FredrikLLarsen/STM32F411_DRV8302_FOC_PCBA/STM32 - BLDC Driver/Production/bom.csv

Designator | Footprint | Quantity | Value | LCSC Part #
C1, C11, C12, C42, C43 | 0805 | 5 | 4.7u low esr (C1779)
C10 | 0603 | 1 | 120p (C107035)
C13, C14, C15, C16, C18, C19, C21, C22, C23, C45, C66 | 0805 | 11 | 100nF 50V (C28233)
C17 | 0805 | 1 | 2.2u (C5448893)
C2, C7 | 1206 | 2 | 1uF (C13832)
C20 | 0805 | 1 | 10uF (C15850)
C24, C35 | C_Elec_10x10.2 | 2 | 220uF (C46550422)
C25, C26, C28, C29, C30, C31, C33, C34, C51, C61, C62, C68, C74 | 0805 | 13 | 0.1uF (C28233)
C27 | CP_Elec_5x5.4 | 1 | 47uF_P (C18221497)
C3 | 1206 | 1 | 2.2uF (C920964)
C32 | 0805 | 1 | 0.01uF (C1710)
C36, C37, C38, C39, C40, C75 | 0805 | 6 | 22uF (C45783)
C4 | 0805 | 1 | 10nF (C1710)
C41 | C_Elec_8x10.2 | 1 | 100uF 63V (C7471891)
C44, C67 | 1206 | 2 | 4.7uF 50V (C29823)
C46 | 0805 | 1 | 4.7nF (C1744)
C5, C6 | 0805 | 2 | 2.2nF (C28260)
C53, C56 | 1206 | 2 | 1nF (C9196)
C55, C59, C60 | 1206 | 3 | 2.2uF (C50254)
C8 | 0603 | 1 | 22nF (C376821)
C9 | 0603 | 1 | 6.8n (C1631)
D1 | D_SOD-123 | 1 | D_Zener (C173406)
D2 | D_SMA-SMB_Universal_Handsoldering | 1 | B330A-13-F (C110485)
D5, D7, D8 | D_SOD-323 | 3 | D_Zener (C67528)
J1 | HRS_FH34SRJ-10S-0.5SH_50_ | 1 | FH34SRJ-10S-0.5SH_50_
J10 | TerminalBlock_bornier-3_P5.08mm | 1 | Screw_Terminal_01x03
J2, J4, J5, J7 | PinHeader_1x03_P2.54mm_Vertical | 4 | Conn_01x03_Pin
J3 | PinHeader_1x04_P2.54mm_Vertical | 1 | Conn_01x04_Pin
J8 | G-SWITCH_GT-USB-7010B | 1 | GT-USB-7010B
J9 | AMASS_XT30PW-M_1x02_P2.50mm_Horizontal | 1 | Conn_01x02_Pin
L1 | L_Changjiang_FXL0630 | 1 | 22uH (C177244)
L2, L4 | L_7.3x7.3_H3.5 | 2 | 15uH (C216196)
Q1, Q2, Q3, Q4, Q5, Q6 | TRANS_SIR182DP-T1-RE3 | 6 | SIR182DP-T1-RE3
R1, R11, R12, R13, R2, R5 | 0805 | 6 | 10k (C17414)
R10 | 0603 | 1 | 3.3R (C22979)
R14, R15 | 0603 | 2 | 5.1k (C22356620)
R16, R17 | 0603 | 2 | 0R
R18 | 0603 | 1 | 3k3 (C22356670)
R19 | 0603 | 1 | 18k (C2907111)
R20 | 0603 | 1 | 15k (C22356635)
R21, R23 | 0603 | 2 | 2.2k (C4190)
R26, R27 | 0603 | 2 | 56R (C2930118)
R28 | 0603 | 1 | 1k (C22356624)
R29 | 0805 | 1 | 80.6k (C2960781)
R31 | 0805 | 1 | 8.2k (C17828)
R4 | 0805 | 1 | 0R (C17477)
R42, R55 | 2512 | 2 | 10mOhm (C393072)
R43, R50, R52, R9 | 0603 | 4 | 34.8k (C23141)
R44, R46, R49, R51, R53, R56 | 0805 | 6 | 10R (C17415)
R45, R47, R48, R6 | 0603 | 4 | 4.99k (C23046)
R59, R62 | 0805 | 2 | 64.9k (C17788)
R60 | 0603 | 1 | 100k (C15458)
R61, R64 | 0805 | 2 | 24.9k (C17571)
R63 | 0603 | 1 | 57.6k (C204216)
R7 | 0603 | 1 | 200k (C25811)
R8 | 0402 | 1 | 1M (C26083)
TH1 | 0805 | 1 | CMFB103F3950FANT (C51597)
TP10, TP15, TP16, TP19, TP20, TP21, TP23, TP24, TP25, TP26 | TestPoint_Pad_D3.0mm | 10 | TestPoint
TP11, TP12, TP6 | TestPoint_Pad_D4.0mm | 3 | TestPoint
U1, U3 | DDA0008E-IPC_A | 2 | LMR38020SDDAR
U2 | SOP50P810X120-57N | 1 | DRV8302DCAR
U4 | SOT-223-3_TabPin2 | 1 | LD1117S33TR_SOT223
U5 | QFN-48-1EP_7x7mm_P0.5mm_EP5.6x5.6mm | 1 | STM32F411CEUx
U6, U7 | SOT-363_SC-70-6 | 2 | LM66100DCK
Y1 | Crystal_SMD_3225-4Pin_3.2x2.5mm_HandSoldering | 1 | Crystal_GND24 (C5444547)
