FredrikLLarsen/STM32F411_DRV8302_FOC_PCBA/STM32 - BLDC Driver/FL50-15 Adapter/production/bom.csv

Designator | Footprint | Quantity | Value | LCSC Part #
J1 | PinHeader_1x10_P2.54mm_Vertical | 1 | Conn_01x10_Pin
J7 | HRS_FH34SRJ-10S-0.5SH_50_ | 1 | FH34SRJ-10S-0.5SH_50_
