FredrikLLarsen/STM32F411_DRV8302_FOC_PCBA/STM32 - BLDC Driver/Production/REV_B/STM32 - BLDC Driver - REVB BOM.csv

Reference | Qty | Value | DNP | Exclude from BOM | Exclude from Board | Footprint | Datasheet
C1,C11,C12,C50 | 4 | 4.7u low esr (C1779) |  |  |  | Capacitor_SMD:C_0805_2012Metric_Pad1.18x1.45mm_HandSolder | ~
C2,C7 | 2 | 1uF (C13832) |  |  |  | Capacitor_SMD:C_1206_3216Metric_Pad1.33x1.80mm_HandSolder | ~
C3 | 1 | 2.2uF (C920964) |  |  |  | Capacitor_SMD:C_1206_3216Metric_Pad1.33x1.80mm_HandSolder | ~
C4 | 1 | 10nF (C1710) |  |  |  | Capacitor_SMD:C_0805_2012Metric_Pad1.18x1.45mm_HandSolder | ~
C5,C6 | 2 | 2.2nF (C28260) |  |  |  | Capacitor_SMD:C_0805_2012Metric_Pad1.18x1.45mm_HandSolder | ~
C8 | 1 | 22nF (C376821) |  |  |  | Capacitor_SMD:C_0603_1608Metric_Pad1.08x0.95mm_HandSolder | ~
C9 | 1 | 6.8n (C1631) |  |  |  | Capacitor_SMD:C_0603_1608Metric_Pad1.08x0.95mm_HandSolder | ~
C10 | 1 | 120p (C107035) |  |  |  | Capacitor_SMD:C_0603_1608Metric_Pad1.08x0.95mm_HandSolder | ~
C20 | 1 | 10uF (C15850) |  |  |  | Capacitor_SMD:C_0805_2012Metric_Pad1.18x1.45mm_HandSolder | ~
C23,C37,C44,C45,C47,C48,C49,C52,C54 | 9 | 100nF 50V (C28233) |  |  |  | Capacitor_SMD:C_0805_2012Metric_Pad1.18x1.45mm_HandSolder | ~
C24,C35 | 2 | 220uF (C46550422) |  |  |  | Capacitor_SMD:C_Elec_10x10.2 | ~
C25,C26,C28,C29,C30,C31,C33,C34,C40,C42,C51,C62 | 12 | 0.1uF (C28233) |  |  |  | Capacitor_SMD:C_0805_2012Metric_Pad1.18x1.45mm_HandSolder | ~
C27 | 1 | 47uF_P (C18221497) |  |  |  | Capacitor_SMD:CP_Elec_5x5.4 | ~
C32 | 1 | 0.01uF (C1710) |  |  |  | Capacitor_SMD:C_0805_2012Metric_Pad1.18x1.45mm_HandSolder | ~
C36 | 1 | C22036 |  |  |  | Capacitor_Tantalum_SMD:CP_EIA-3528-21_Kemet-B | ~
C38,C53 | 2 | 1nF (C9196) |  |  |  | Capacitor_SMD:C_1206_3216Metric | ~
C39,C55,C60 | 3 | 2.2uF (C50254) |  |  |  | Capacitor_SMD:C_1206_3216Metric_Pad1.33x1.80mm_HandSolder | ~
C41 | 1 | 100uF 63V (C7471891) |  |  |  | Capacitor_SMD:C_Elec_8x10.2 | ~
C43 | 1 | 2.2u C5448893 |  |  |  | Capacitor_SMD:C_0805_2012Metric_Pad1.18x1.45mm_HandSolder | ~
C46 | 1 | 4.7nF (C1744) |  |  |  | Capacitor_SMD:C_0805_2012Metric_Pad1.18x1.45mm_HandSolder | ~
C56 | 1 | 1nF (C9196) |  |  |  | Capacitor_SMD:C_1206_3216Metric_Pad1.33x1.80mm_HandSolder | ~
C57,C58 | 2 | 10pF (C520053) |  |  |  | Capacitor_SMD:C_0805_2012Metric_Pad1.18x1.45mm_HandSolder | ~
D1 | 1 | D_Zener (C173406) |  |  |  | Diode_SMD:D_SOD-123 | ~
D2 | 1 | B330A-13-F (C110485) |  |  |  | Diode_SMD:D_SMA-SMB_Universal_Handsoldering | ~
D3,D9,D15 | 3 | C84260 |  |  |  | LED_SMD:LED_0805_2012Metric_Pad1.15x1.40mm_HandSolder | ~
D4,D6,D7,D11 | 4 | C5342734 |  |  |  | LED_SMD:LED_0603_1608Metric_Pad1.05x0.95mm_HandSolder | ~
D5,D8,D14 | 3 | D_Zener (C67528) |  |  |  | Diode_SMD:D_SOD-323 | ~
D10 | 1 | IN5819 (C437199) |  |  |  | Diode_SMD:D_SMA_Handsoldering | ~
D12,D13 | 2 | C511254 |  |  |  | Diode_SMD:D_SOD-323_HandSoldering | ~
H1,H2,H3,H4 | 4 | MountingHole_Pad |  | Excluded from BOM |  | MountingHole:MountingHole_3.2mm_M3_Pad_Via | ~
J1 | 1 | FH34SRJ-10S-0.5SH_50_ |  |  |  | FH34SRJ-10S-0.5SH:HRS_FH34SRJ-10S-0.5SH_50_
J2,J4,J5,J12 | 4 | Conn_01x03_Pin |  |  |  | Connector_PinHeader_2.54mm:PinHeader_1x03_P2.54mm_Vertical | ~
J3,J11 | 2 | Conn_01x04_Socket |  |  |  | Connector_JST:JST_XH_B4B-XH-A_1x04_P2.50mm_Vertical | ~
J6 | 1 | TC2050 |  | Excluded from BOM |  | Connector:Tag-Connect_TC2050-IDC-NL_2x05_P1.27mm_Vertical | https://www.tag-connect.com/wp-content/uploads/bsk-pdf-manager/TC2050-IDC-NL_Datasheet_8.pdf
J7 | 1 | Conn_01x06_Pin |  |  |  | Connector_PinSocket_2.00mm:PinSocket_1x06_P2.00mm_Vertical | ~
J8 | 1 | GT-USB-7010B |  |  |  | GT-USB-7010B:G-SWITCH_GT-USB-7010B
J9 | 1 | Conn_01x02_Pin |  |  |  | Connector_AMASS:AMASS_XT30PW-M_1x02_P2.50mm_Horizontal | ~
J10 | 1 | Screw_Terminal_01x03 |  |  |  | TerminalBlock:TerminalBlock_bornier-3_P5.08mm | ~
J13 | 1 | Conn_01x02 |  |  |  | Connector_JST:JST_XH_B2B-XH-A_1x02_P2.50mm_Vertical | ~
JP1,JP2,JP3,JP4,JP5,JP6,JP7,JP8,JP9,JP10,JP11,JP12,JP13,JP14,JP15,JP16,JP17,JP18,JP20 | 19 | SolderJumper_2_Open |  | Excluded from BOM |  | Jumper:SolderJumper-2_P1.3mm_Open_RoundedPad1.0x1.5mm | ~
JP19 | 1 | SolderJumper_2_Open |  | Excluded from BOM |  |  | ~
L1 | 1 | 22uH (C177244) |  |  |  | Inductor_SMD:L_Changjiang_FXL0630 | ~
L2 | 1 | C5189962 |  |  |  | Inductor_SMD:L_Bourns_SRP7028A_7.3x6.6mm | ~
NT1 | 1 | NetTie_3_Tee |  | Excluded from BOM |  | NetTie:NetTie-3_SMD_Pad0.5mm | ~
NT3,NT4,NT6,NT7,NT8,NT9 | 6 | NetTie_2 |  | Excluded from BOM |  | NetTie:NetTie-2_SMD_Pad0.5mm | ~
Q1,Q2,Q4,Q6,Q7,Q8 | 6 | C431185 |  |  |  | SIR182DP:TRANS_SIR182DP-T1-RE3
R1,R2,R5,R11,R12,R30 | 6 | 10k (C17414) |  |  |  | Resistor_SMD:R_0805_2012Metric_Pad1.20x1.40mm_HandSolder | ~
R3,R25,R40 | 3 | 0R (C95177) |  |  |  | Resistor_SMD:R_0603_1608Metric_Pad0.98x0.95mm_HandSolder | ~
R4 | 1 | 100R (C105588) |  |  |  | Resistor_SMD:R_0603_1608Metric_Pad0.98x0.95mm_HandSolder | ~
R6,R38,R45,R48 | 4 | 4.99k (C23046) |  |  |  | Resistor_SMD:R_0603_1608Metric_Pad0.98x0.95mm_HandSolder | ~
R7 | 1 | 200k (C25811) |  |  |  | Resistor_SMD:R_0603_1608Metric_Pad0.98x0.95mm_HandSolder | ~
R8 | 1 | 1M (C26083) |  |  |  | Resistor_SMD:R_0402_1005Metric_Pad0.72x0.64mm_HandSolder | ~
R9,R37,R43,R52 | 4 | 34.8k (C23141) |  |  |  | Resistor_SMD:R_0603_1608Metric_Pad0.98x0.95mm_HandSolder | ~
R10 | 1 | 3.3R (C22979) |  |  |  | Resistor_SMD:R_0603_1608Metric_Pad0.98x0.95mm_HandSolder | ~
R13,R22,R24,R33 | 4 | 820R (C137608) |  |  |  | Resistor_SMD:R_0603_1608Metric_Pad0.98x0.95mm_HandSolder | ~
R14,R15,R47 | 3 | 5.1k (C22356620) |  |  |  | Resistor_SMD:R_0603_1608Metric_Pad0.98x0.95mm_HandSolder | ~
R16,R17 | 2 | 0R |  |  |  | Resistor_SMD:R_0603_1608Metric_Pad0.98x0.95mm_HandSolder | ~
R18 | 1 | 10k |  |  |  | Resistor_SMD:R_0603_1608Metric_Pad0.98x0.95mm_HandSolder | ~
R19 | 1 | 31.6k |  |  |  | Resistor_SMD:R_0603_1608Metric_Pad0.98x0.95mm_HandSolder | ~
R20 | 1 | 15k (C22356635) |  |  |  | Resistor_SMD:R_0603_1608Metric_Pad0.98x0.95mm_HandSolder | ~
R21,R23 | 2 | 2.2k (C4190) |  |  |  | Resistor_SMD:R_0603_1608Metric_Pad0.98x0.95mm_HandSolder | ~
R26,R27 | 2 | 56R (C2930118) |  |  |  | Resistor_SMD:R_0603_1608Metric_Pad0.98x0.95mm_HandSolder | ~
R28,R32,R39 | 3 | 1k (C22356624) |  |  |  | Resistor_SMD:R_0603_1608Metric_Pad0.98x0.95mm_HandSolder | ~
R29 | 1 | CHECK VAL |  |  |  | Resistor_SMD:R_0805_2012Metric_Pad1.20x1.40mm_HandSolder | ~
R31 | 1 | 8.2k (C17828) |  |  |  | Resistor_SMD:R_0805_2012Metric_Pad1.20x1.40mm_HandSolder | ~
R34,R35,R44,R46,R49,R51 | 6 | 10R (C17415) |  |  |  | Resistor_SMD:R_0805_2012Metric_Pad1.20x1.40mm_HandSolder | ~
R36,R42,R55 | 3 | 10mOhm (C393072) |  |  |  | Resistor_SMD:R_2512_6332Metric_Pad1.40x3.35mm_HandSolder | ~
R41 | 1 | 0R (C17477) |  |  |  | Resistor_SMD:R_0805_2012Metric_Pad1.20x1.40mm_HandSolder | ~
TH1 | 1 | CMFB103F3950FANT (C51597) |  |  |  | Resistor_SMD:R_0805_2012Metric_Pad1.20x1.40mm_HandSolder | ~
TP7,TP10,TP14,TP23 | 4 | TestPoint |  |  |  | TestPoint:TestPoint_Pad_D1.0mm | ~
U1 | 1 | ME2108A30PG |  |  |  | Package_TO_SOT_SMD:SOT-89-3 | https://www.lcsc.com/datasheet/C19056.pdf
U2 | 1 | DRV8302DCAR |  |  |  | DRV8302DCAR:SOP50P810X120-57N
U3,U6 | 2 | LM66100DCK |  |  |  | Package_TO_SOT_SMD:SOT-363_SC-70-6 | https://www.ti.com/lit/ds/symlink/lm66100.pdf
U4 | 1 | LD1117S33TR_SOT223 |  |  |  | Package_TO_SOT_SMD:SOT-223-3_TabPin2 | http://www.st.com/st-web-ui/static/active/en/resource/technical/document/datasheet/CD00000544.pdf
U7 | 1 | MCP4017T-503E/LT |  |  |  | Package_TO_SOT_SMD:SOT-363_SC-70-6 | http://ww1.microchip.com/downloads/en/DeviceDoc/22147a.pdf
U8 | 1 | STM32F411RCTx |  |  |  | Package_QFP:LQFP-64_10x10mm_P0.5mm | https://www.st.com/resource/en/datasheet/stm32f411rc.pdf
Y2 | 1 | Crystal_GND24 (C5444547) |  |  |  | Crystal:Crystal_SMD_3225-4Pin_3.2x2.5mm_HandSoldering | ~
