FredrikLLarsen/STM32F411_DRV8302_FOC_PCBA/STM 32 - BLDC Driver V3 - VARIANT B/STM32 BLDC Driver V3/_restore_backup_2026-09-18T21-46-55-770/production/HOMEBREW_V3__bom.csv

Designator | Footprint | Quantity | Value | LCSC Part #
C10, C12, C13, C14, C15, C25, C26, C28, C32, C37 | 0603 | 10 | 2.2uF (C57895)
C11, C2, C5, C6, C7, C9 | 0603 | 6 | 22pF (C7419421)
C19, C22, C31, C38 | 1206 | 4 | 1uf 100V (C13832)
C27 | 0603 | 1 | 22nF (C696861)
C29 | 1206 | 1 | 4.7uF 100V (C22367839)
C30 | 0603 | 1 | 220nF 100V (C7300906)
C33, C34 | 0603 | 2 | 22uF 10V (C86295)
C35, C36, C41 | 0603 | 3 | 10uF 10V (C5137565)
C39 | 0805 | 1 | 47uF 10V (C124129)
C43, C47, C48, C49, C50 | 0603 | 5 | 0.1uF (C52711259)
C44, C45 | C_Elec_8x10.2 | 2 | 100uF 63V (C7471891)
C57, C58 | 0805 | 2 | 10pF (C520053)
C62, C63, C80, C82, C83, C84, C85, C86 | 0603 | 8 | 100nF 50V (C1591)
C64, C65, C72 | 0805 | 3 | 100nF 50V (C28233)
C66, C67, C68, C69, C70, C71 | 0805 | 6 | 100nF 100V X7R
C73 | 0603 | 1 | 4.7uF 16V (C7432772)
C74, C75, C76, C77, C78, C79, C81 | 0603 | 7 | 1nF (C374073)
D10, D12, D13, D7, D8, D9 | 0603 | 6 | C5342734
D11 | D_SMA_Handsoldering | 1 | B340A
D14, D15, D16, D17, D18, D19 | D_SMB | 6 | C28646299
IC1 | SOIC127P600X170-9N | 1 | MP1584EN-LF-Z
IC2 | SOT8 | 1 | LM66200DRLR
J1 | PinHeader_1x02_P2.54mm_Vertical | 1 | Conn_01x02_Pin
J11, J5, J7, J8 | STICHED SOLDER PAD_SMALL | 4 | Conn_01x01_Pin
J12 | USB_C_Receptacle_G-Switch_GT-USB-7010ASV | 1 | G-Switch GT-USB-7010ASV
J2, J3, J4 | STICHED SOLDER PAD | 3 | Conn_01x01_Pin
J9 | Molex_Nano-Fit_105313-xx02_1x02_P2.50mm_Horizontal | 1 | Conn_01x02_Pin
JP1, JP10, JP11, JP12, JP13, JP2, JP3, JP5, JP6, JP7, JP8, JP9 | SolderJumper-2_P1.3mm_Open_RoundedPad1.0x1.5mm | 12 | Jumper_2_Small_Open
L1 | L_Abracon_ASPIAIG-F4020 | 1 | 10 µH (C54620135)
L2 | L_Sunlord_MWSA0402S | 1 | 22uH (C41438718)
Q1 | SOT-23 | 1 | BC847
R13, R14, R16, R17, R18, R19 | 0603 | 6 | 10R 0.1W (C109318)
R2, R4, R5, R6, R7, R8 | 0603 | 6 | 2.2R (C2907006)
R20 | 0603 | 1 | 4.3k 1% (C54920924)
R21, R23, R40, R41, R42, R44, R51, R57, R58 | 0603 | 9 | 4k7 100mW (C2907034)
R22, R24, R25, R28, R30, R39, R45 | 0603 | 7 | 820R (C137608)
R26, R29, R32, R34, R43 | 0603 | 5 | 100k 1% (C2906980)
R27 | 0603 | 1 | 24.9k 1% (C2930080)
R33 | 0603 | 1 | 68k (C2907063)
R35 | 0805 | 1 | 250k (C2501409)
R36 | 0603 | 1 | 22k (C2907015)
R37, R38 | 0805 | 2 | 8.2k (C17828)
R46, R47 | 0603 | 2 | 22R (C23345)
R48, R59, R60, R62, R68 | 0603 | 5 | 0R (C2906974)
R52, R53 | 0603 | 2 | 5.1k (C2907044)
R55, R63, R64, R65, R66, R67 | 0603 | 6 | 10k 100mW (C98220)
TH2, TH3 | 0805 | 2 | CMFB103F3950FANT (C51597)
U1, U2, U3 | EPC_QFN-13-3EP_3.5x5mm_P0.5mm | 3 | EPC23104
U10 | LQFP-64_10x10mm_P0.5mm | 1 | STM32G431RBTx
U11 | TSSOP-14_4.4x5mm_P0.65mm | 1 | AS5047D
U13 | SOT-23-6 | 1 | USBLC6-2SC6
U4 | SOIC-16_3.9x9.9mm_P1.27mm | 1 | CH340C
U5 | SOIC-8_3.9x4.9mm_P1.27mm | 1 | 24LC256
U6 | Texas_HTSOP-8-1EP_3.9x4.9mm_P1.27mm_EP2.95x4.9mm_Mask2.4x3.1mm_ThermalVias | 1 | LMR36520ADDA
U7, U8, U9 | SOIC-8_3.9x4.9mm_P1.27mm | 3 | ACS725xLCTR-20AB
Y2 | Crystal_SMD_3225-4Pin_3.2x2.5mm_HandSoldering | 1 | Crystal_GND24 (C5444547)
