FredrikLLarsen/STM32F411_DRV8302_FOC_PCBA/STM 32 - BLDC Driver V3 - VARIANT B/STM32 BLDC Driver V3/_restore_backup_2026-09-18T21-46-55-770/.step

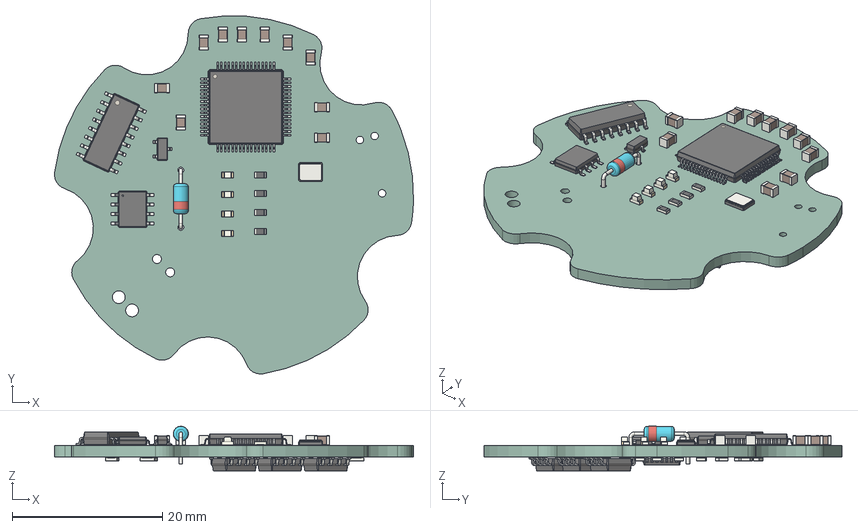
[picture p1: CAD file, 2026-10-09]
STM 32 - BLDC Driver V3 - VARIANT B/STM32 BLDC Driver V3/_restore_backup_2026-09-18T21-46-55-770/.step
47.8 x 47.7 x 5.94 mm
LED_0603_1608Metric x 4
R_0603_1608Metric x 8
LQFP-64_10x10mm_P0.5mm
C_0805_2012Metric x 10
D_DO-35_SOD27_P7.62mm_Horizontal
Texas_HTSOP_8_1EP_39x49mm_P127mm_EP285x49mm_Mask24x31mm_ThermalVias
SOIC-16_3.9x9.9mm_P1.27mm
Crystal_SMD_3225-4Pin_3.2x2.5mm
SOT-23
TSSOP-14_4.4x5mm_P0.65mm
R_0805_2012Metric x 7
SOIC-8_3.9x4.9mm_P1.27mm x 3
STMEC79_PCB
