FredrikLLarsen/STM32F411_DRV8302_FOC_PCBA/STM32 - BLDC Driver V2/AS5047P Encoder/AS5047P Encoder/AS5047P Encoder.kicad_pcb

## KiCad design STM32 - BLDC Driver V2/AS5047P Encoder/AS5047P Encoder/AS5047P Encoder.kicad_pcb (2026-10-09)

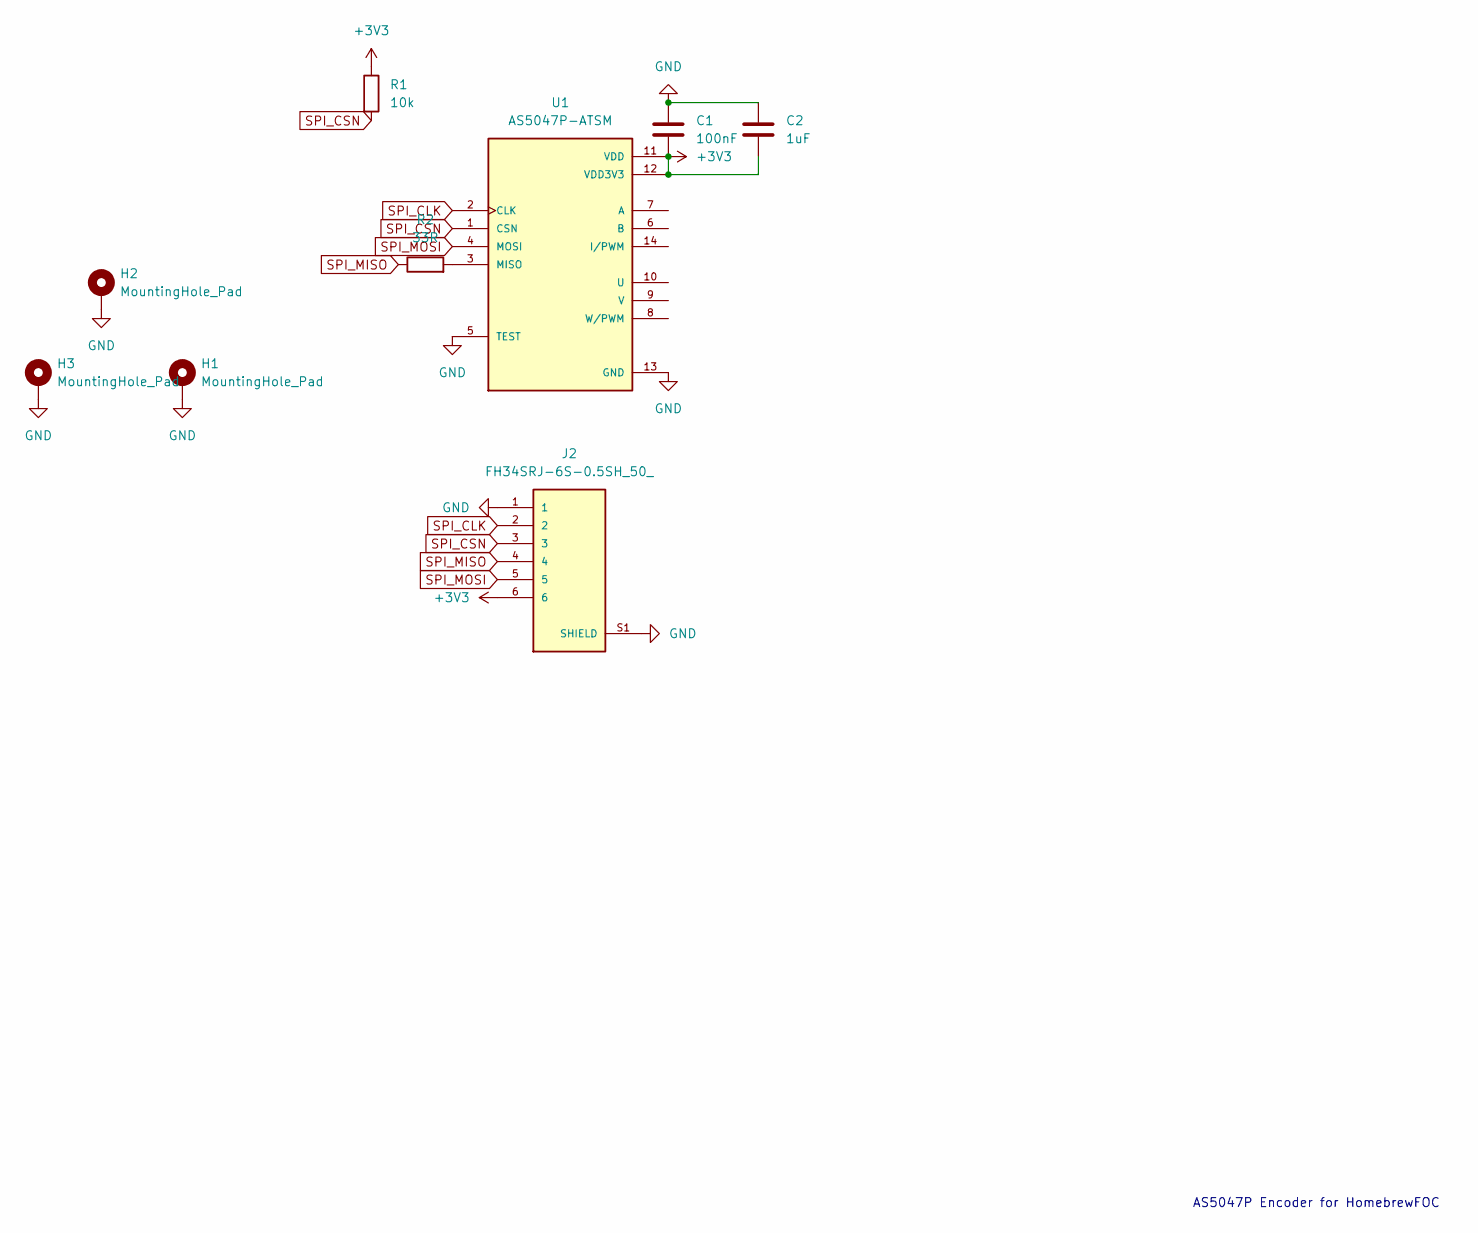
[picture p2: schematic AS5047P Encoder.kicad_sch]

Parts:
C1: 100nF; C_0603_1608Metric_Pad1.08x0.95mm_HandSolder
C2: 1uF; C_0603_1608Metric_Pad1.08x0.95mm_HandSolder
H1, H2, H3: MountingHole_Pad; MountingHole_3.2mm_M3_ISO7380_Pad
J2: FH34SRJ-6S-0.5SH_50_; HRS_FH34SRJ-6S-0.5SH_50_
R1: 10k; R_0603_1608Metric_Pad0.98x0.95mm_HandSolder
R2: 33R; R_0603_1608Metric_Pad0.98x0.95mm_HandSolder
U1: AS5047P-ATSM; SOP65P640X120-14N; PARTREV 1-01

Connections:
+3V3: C1.2, C2.2, J2.6, R1.1, U1.11 (VDD), U1.12 (VDD3V3)
GND: C1.1, C2.1, H1.1, H2.1, H3.1, J2.1, J2.S1 (SHIELD), J2.S2 (SHIELD), U1.5 (TEST), U1.13 (GND)
unnamed: R2.2, U1.3 (MISO)
SPI_CLK: J2.2, U1.2 (CLK)
SPI_CSN: J2.3, R1.2, U1.1 (CSN)
SPI_MISO: J2.4, R2.1
SPI_MOSI: J2.5, U1.4 (MOSI)

Notes on the sheet:
AS5047P Encoder for HomebrewFOC

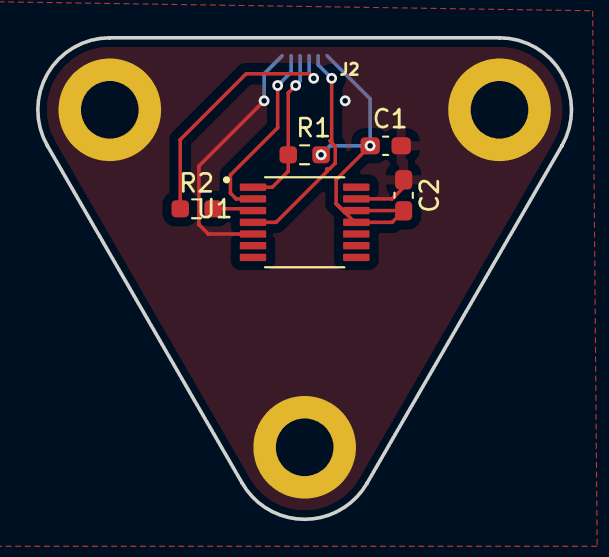
[picture p3: board AS5047P Encoder.kicad_pcb from above]

Board: 2 copper layers, 29.7 x 26.8 mm, 9 parts (1 on the bottom side), 7 nets.
