FredrikLLarsen/STM32F411_DRV8302_FOC_PCBA/STM 32 - BLDC Driver V3/STM32 BLDC Driver V3/_restore_backup_2026-09-18T21-46-55-770/STM32 BLDC Driver V3.kicad_pcb

## KiCad design STM 32 - BLDC Driver V3/STM32 BLDC Driver V3/_restore_backup_2026-09-18T21-46-55-770/STM32 BLDC Driver V3.kicad_pcb (2026-10-09)

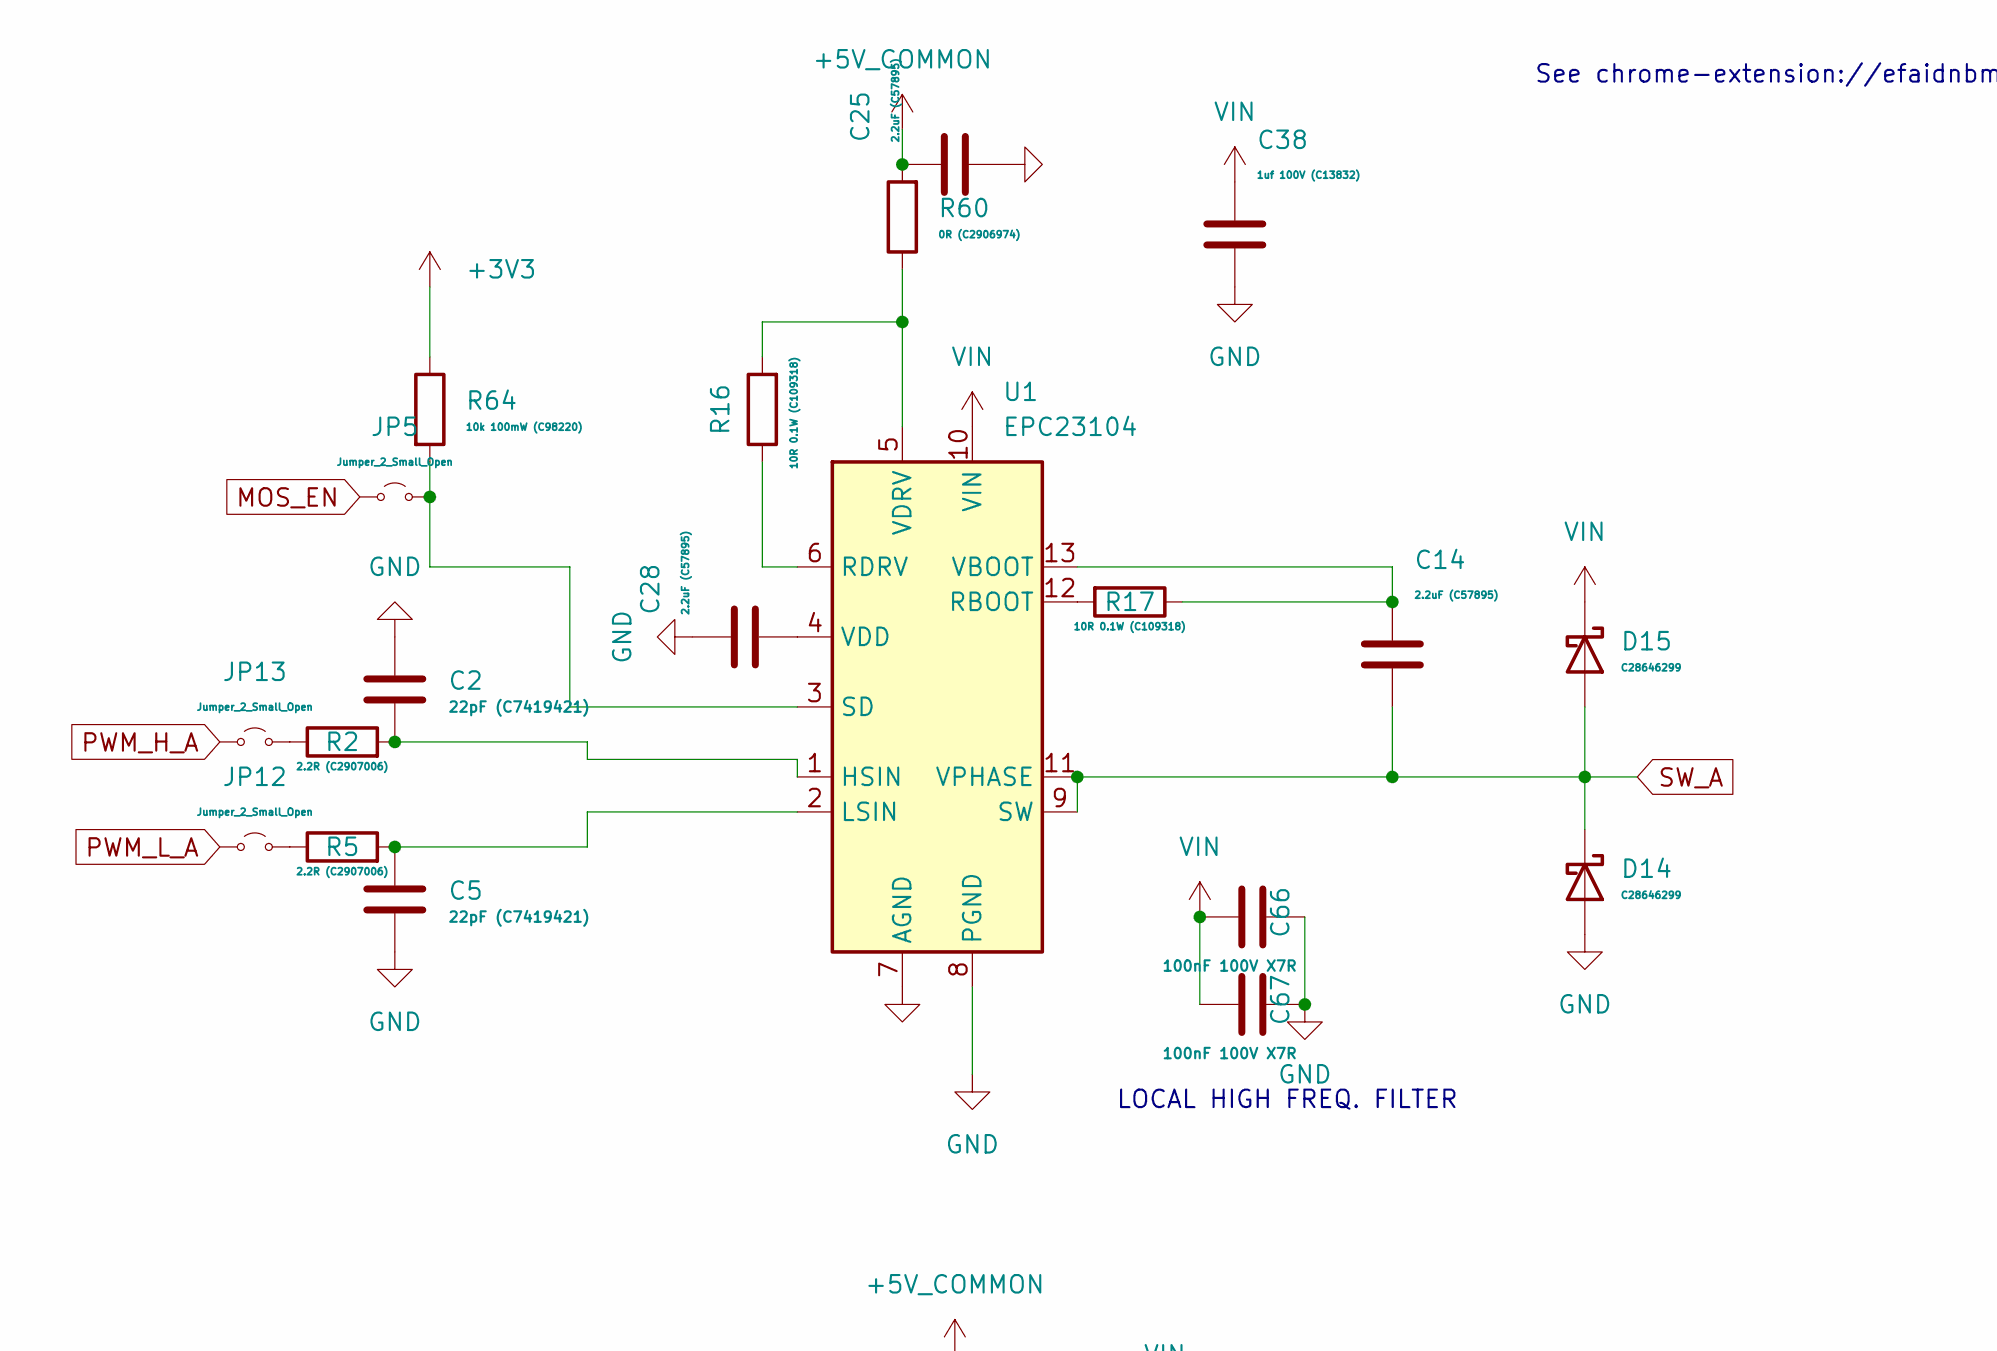
[picture p4: schematic STM32BLDCV3-DRIVER.kicad_sch, part in row 1, column 1]

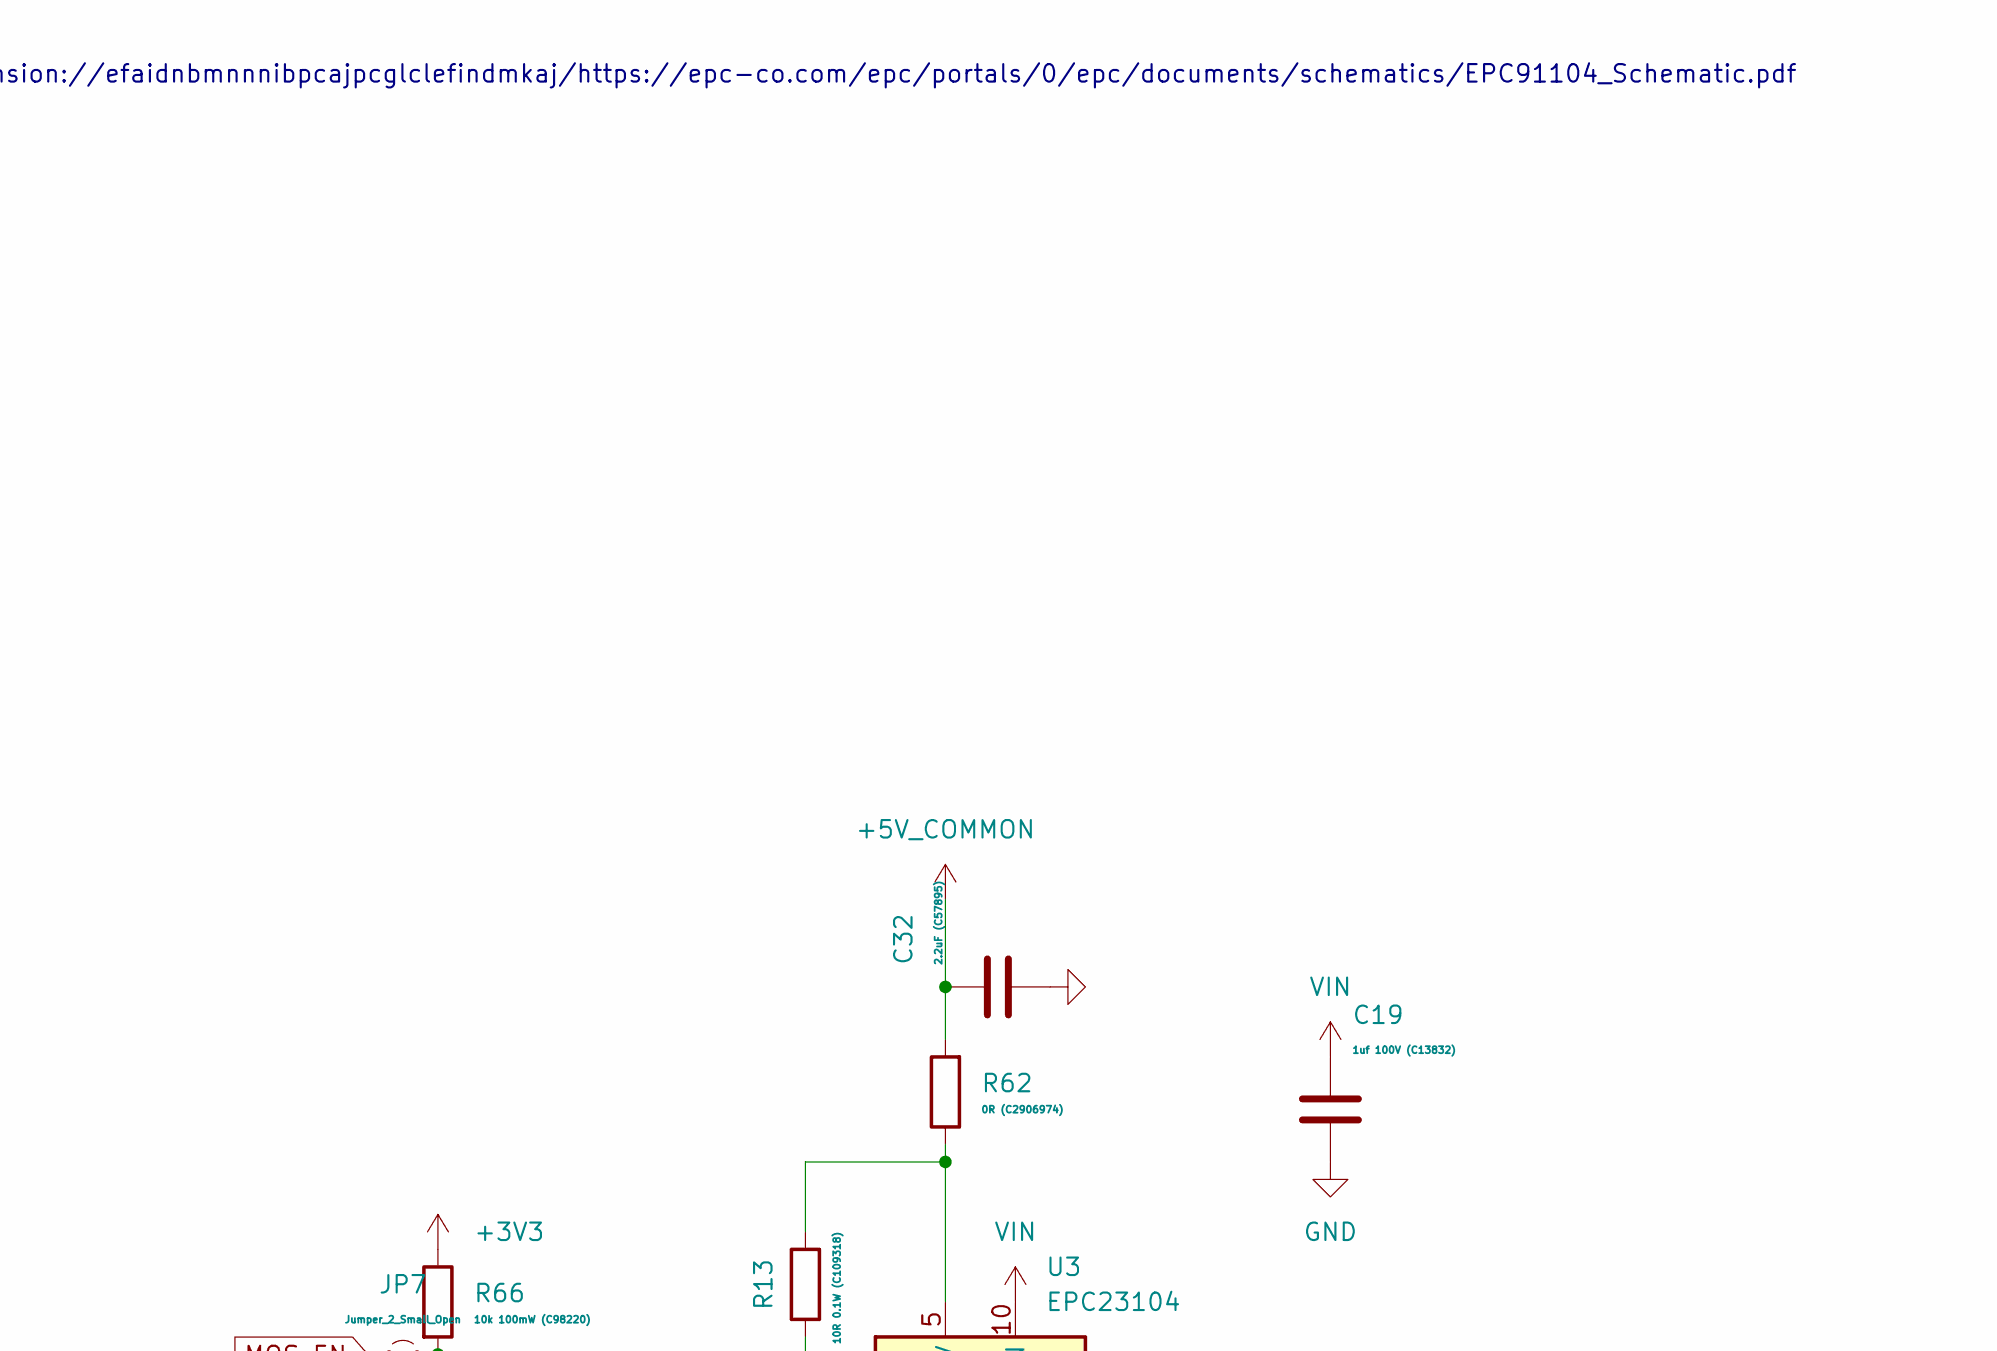
[picture p5: schematic STM32BLDCV3-DRIVER.kicad_sch, part in row 1, column 2]

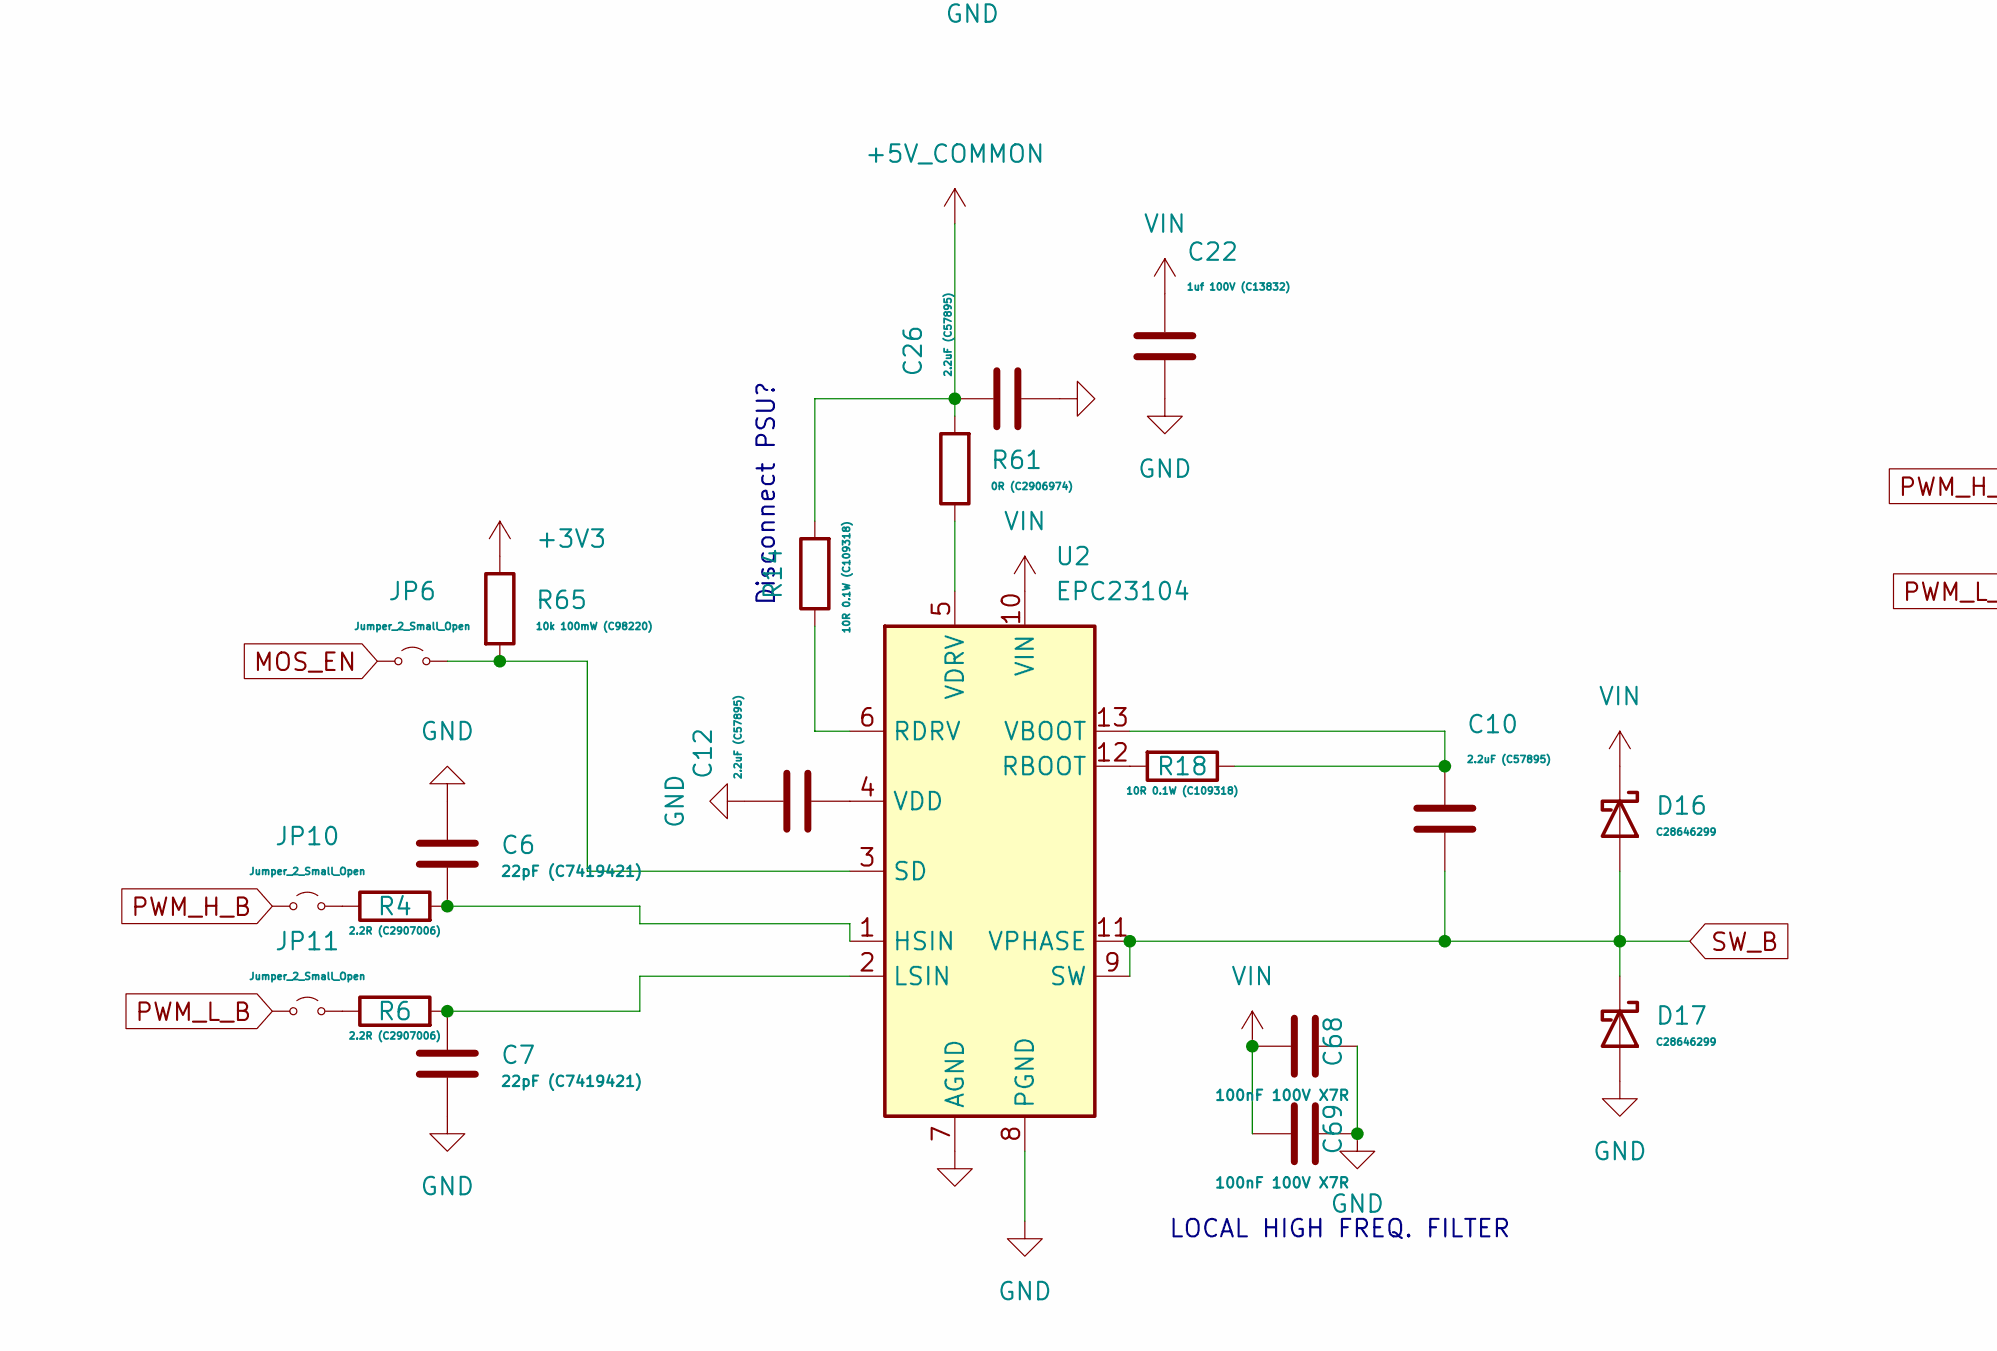
[picture p6: schematic STM32BLDCV3-DRIVER.kicad_sch, part in row 2, column 1]

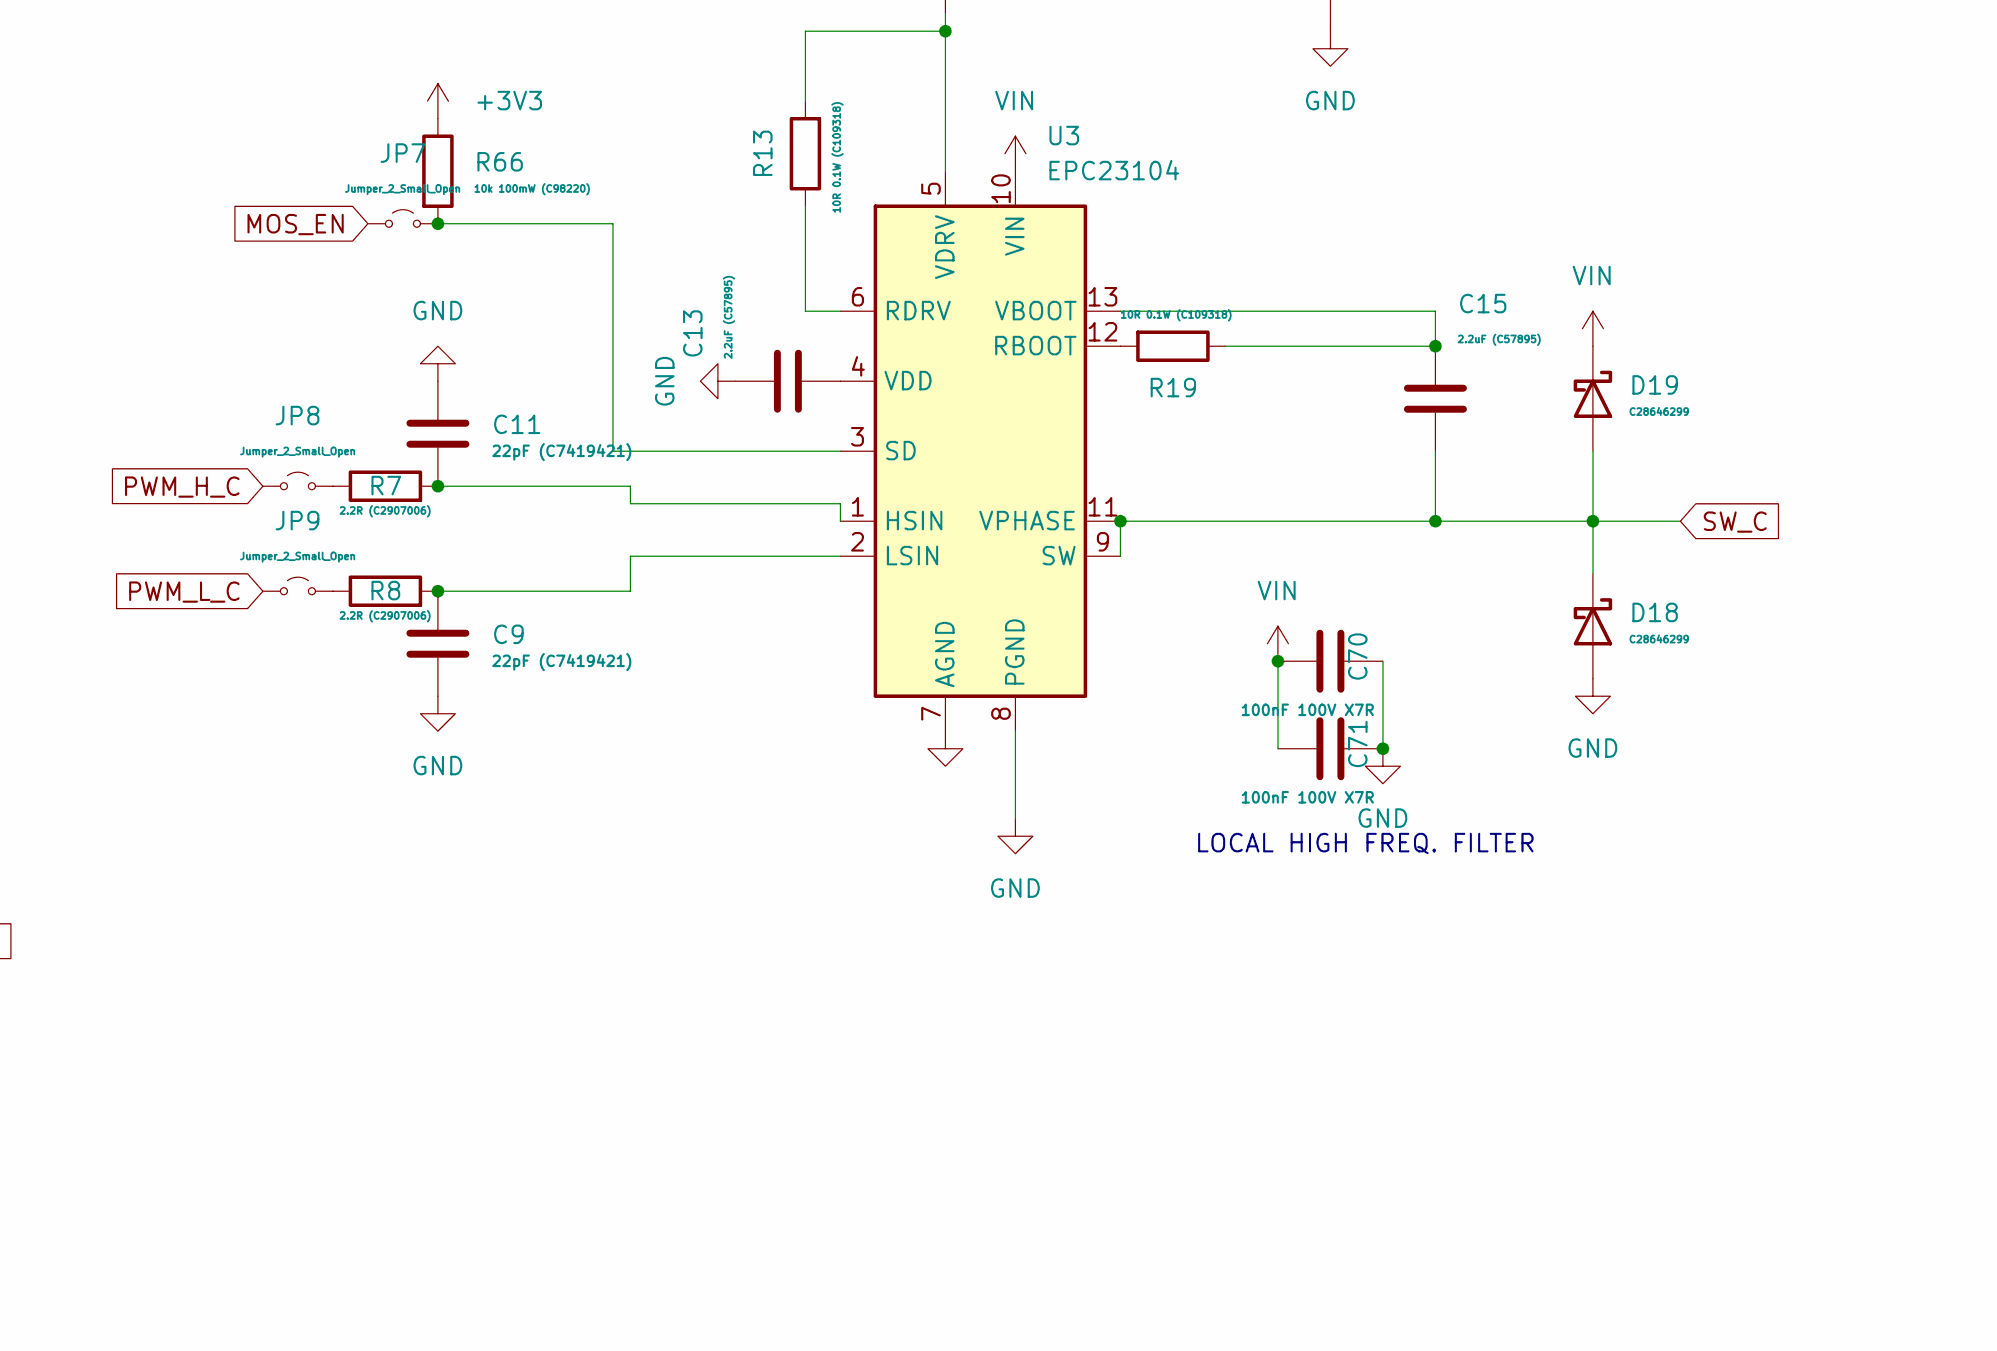
[picture p7: schematic STM32BLDCV3-DRIVER.kicad_sch, part in row 2, column 2]

Parts:
C2, C5, C6, C7, C9, C11: 22pF (C7419421); C_0603_1608Metric_Pad1.08x0.95mm_HandSolder
C10, C12, C13, C14, C15, C25, C26, C28, C32: 2.2uF (C57895); C_0603_1608Metric_Pad1.08x0.95mm_HandSolder
C19, C22, C38: 1uf 100V (C13832); C_1206_3216Metric_Pad1.33x1.80mm_HandSolder
C66, C67, C68, C69, C70, C71: 100nF 100V X7R; C_0805_2012Metric_Pad1.18x1.45mm_HandSolder
D14, D15, D16, D17, D18, D19: C28646299; D_SMB
JP5, JP6, JP7, JP8, JP9, JP10, JP11, JP12, JP13: Jumper_2_Small_Open; SolderJumper-2_P1.3mm_Open_RoundedPad1.0x1.5mm
R2, R4, R5, R6, R7, R8: 2.2R (C2907006); R_0603_1608Metric_Pad0.98x0.95mm_HandSolder
R13, R14, R16, R17, R18, R19: 10R 0.1W (C109318); R_0603_1608Metric_Pad0.98x0.95mm_HandSolder
R60, R61, R62: 0R (C2906974); R_0603_1608Metric_Pad0.98x0.95mm_HandSolder
R64, R65, R66: 10k 100mW (C98220); R_0603_1608Metric_Pad0.98x0.95mm_HandSolder
U1, U2, U3: EPC23104; EPC_QFN-13-3EP_3.5x5mm_P0.5mm

Connections:
+3V3: R64.1, R65.1, R66.1; also elsewhere on the board
+5V_COMMON: C25.1, C26.1, C32.1, R14.2, R60.2, R61.2, R62.2; also elsewhere on the board
GND: C2.1, C5.2, C6.1, C7.2, C9.2, C11.1, C12.1, C13.1, C19.2, C22.2, C25.2, C26.2, C28.1, C32.2, C38.2, C66.1, C67.1, C68.1, C69.1, C70.1, C71.1, D14.2 (A), D17.2 (A), D18.2 (A), U1.7 (AGND), U1.8 (PGND), U2.7 (AGND), U2.8 (PGND), U3.7 (AGND), U3.8 (PGND); also elsewhere on the board
MOS_EN: JP5.1 (A), JP6.1 (A), JP7.1 (A); also elsewhere on the board
unnamed: JP5.2 (B), R64.2, U1.3 (SD)
unnamed: JP6.2 (B), R65.2, U2.3 (SD)
unnamed: JP7.2 (B), R66.2, U3.3 (SD)
unnamed: JP8.2 (B), R7.1
unnamed: JP9.2 (B), R8.1
unnamed: JP10.2 (B), R4.1
unnamed: JP11.2 (B), R6.1
unnamed: JP12.2 (B), R5.1
unnamed: JP13.2 (B), R2.1
unnamed: C2.2, R2.2, U1.1 (HSIN)
unnamed: C5.1, R5.2, U1.2 (LSIN)
unnamed: R17.2, U1.12 (RBOOT)
unnamed: R16.1, U1.6 (RDRV)
unnamed: C14.1, R17.1, U1.13 (VBOOT)
unnamed: C28.2, U1.4 (VDD)
unnamed: R16.2, R60.1, U1.5 (VDRV)
unnamed: C6.2, R4.2, U2.1 (HSIN)
unnamed: C7.1, R6.2, U2.2 (LSIN)
unnamed: R18.2, U2.12 (RBOOT)
unnamed: R14.1, U2.6 (RDRV)
unnamed: C10.1, R18.1, U2.13 (VBOOT)
unnamed: C12.2, U2.4 (VDD)
unnamed: R61.1, U2.5 (VDRV)
unnamed: C11.2, R7.2, U3.1 (HSIN)
unnamed: C9.1, R8.2, U3.2 (LSIN)
unnamed: R19.2, U3.12 (RBOOT)
unnamed: R13.1, U3.6 (RDRV)
unnamed: C15.1, R19.1, U3.13 (VBOOT)
unnamed: C13.2, U3.4 (VDD)
unnamed: R13.2, R62.1, U3.5 (VDRV)
PWM_H_A: JP13.1 (A); also elsewhere on the board
PWM_H_B: JP10.1 (A); also elsewhere on the board
PWM_H_C: JP8.1 (A); also elsewhere on the board
PWM_L_A: JP12.1 (A); also elsewhere on the board
PWM_L_B: JP11.1 (A); also elsewhere on the board
PWM_L_C: JP9.1 (A); also elsewhere on the board
SW_A: C14.2, D14.1 (K), D15.2 (A), U1.9 (SW), U1.11 (VPHASE); also elsewhere on the board
SW_B: C10.2, D16.2 (A), D17.1 (K), U2.9 (SW), U2.11 (VPHASE); also elsewhere on the board
SW_C: C15.2, D18.1 (K), D19.2 (A), U3.9 (SW), U3.11 (VPHASE); also elsewhere on the board
VIN: C19.1, C22.1, C38.1, C66.2, C67.2, C68.2, C69.2, C70.2, C71.2, D15.1 (K), D16.1 (K), D19.1 (K), U1.10 (VIN), U2.10 (VIN), U3.10 (VIN); also elsewhere on the board

Notes on the sheet:
See chrome-extension://efaidnbmnnnibpcajpcglclefindmkaj/https://epc-co.com/epc/portals/0/epc/documents/schematics/EPC91104_Schematic.pdf
LOCAL HIGH FREQ. FILTER
Disconnect PSU?

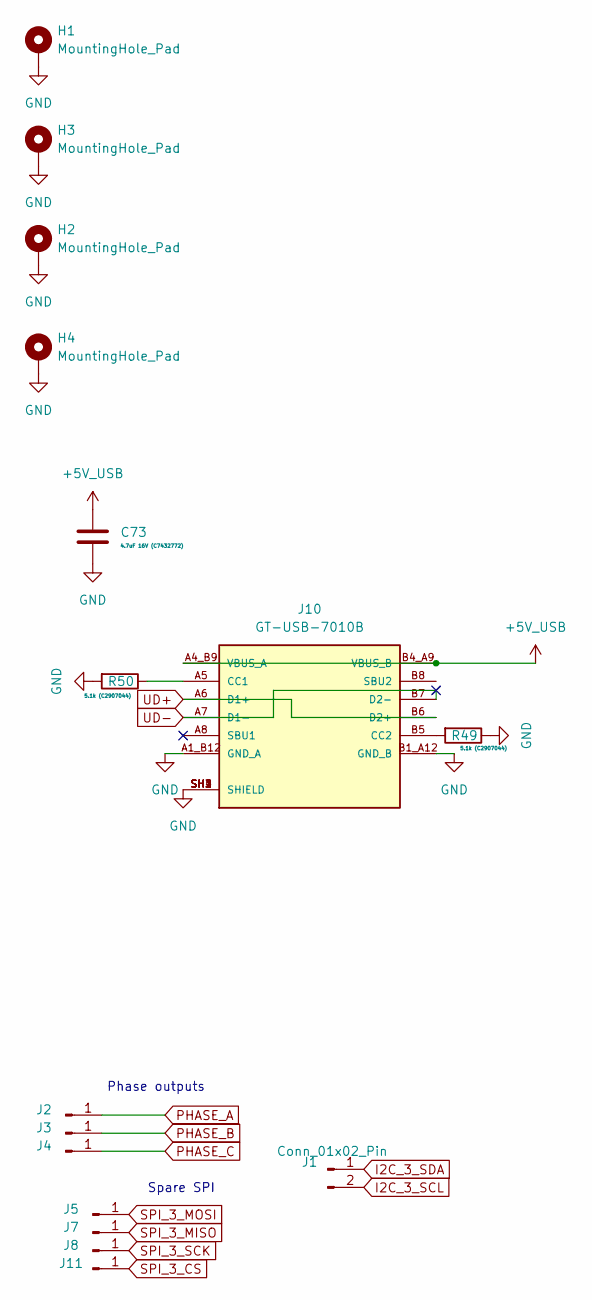
[picture p8: schematic STM32BLDCV3-Connectors.kicad_sch]

Parts:
C73: 4.7uF 16V (C7432772); C_0603_1608Metric_Pad1.08x0.95mm_HandSolder
H1, H2, H3, H4: MountingHole_Pad; MountingHole_2.2mm_M2_Pad_Via
J1: Conn_01x02_Pin; PinHeader_1x02_P2.54mm_Vertical
J2, J3, J4: Conn_01x01_Pin; STICHED SOLDER PAD
J5, J7, J8, J11: Conn_01x01_Pin; STICHED SOLDER PAD_SMALL
J10: GT-USB-7010B; G-SWITCH_GT-USB-7010B; PARTREV A0
R49, R50: 5.1k (C2907044); R_0603_1608Metric_Pad0.98x0.95mm_HandSolder

Connections:
+5V_USB: C73.1, J10.A4_B9 (VBUS_A), J10.B4_A9 (VBUS_B); also elsewhere on the board
GND: C73.2, H1.1 (1_1), H2.1 (1_1), H3.1 (1_1), H4.1 (1_1), J10.A1_B12 (GND_A), J10.B1_A12 (GND_B), J10.SH1 (SHIELD), J10.SH2 (SHIELD), J10.SH3 (SHIELD), J10.SH4 (SHIELD), R49.1, R50.2; also elsewhere on the board
I2C_3_SCL: J1.2; also elsewhere on the board
I2C_3_SDA: J1.1; also elsewhere on the board
unnamed: J10.A5 (CC1), R50.1
unnamed: J10.B5 (CC2), R49.2
PHASE_A: J2.1 (Pin_1_1); also elsewhere on the board
PHASE_B: J3.1 (Pin_1_1); also elsewhere on the board
PHASE_C: J4.1 (Pin_1_1); also elsewhere on the board
SPI_3_CS: J11.1 (Pin_1_1); also elsewhere on the board
SPI_3_MISO: J7.1 (Pin_1_1); also elsewhere on the board
SPI_3_MOSI: J5.1 (Pin_1_1); also elsewhere on the board
SPI_3_SCK: J8.1 (Pin_1_1); also elsewhere on the board
UD+: J10.A6 (D1+), J10.B6 (D2+); also elsewhere on the board
UD-: J10.A7 (D1-), J10.B7 (D2-); also elsewhere on the board

Notes on the sheet:
Phase outputs
Spare SPI

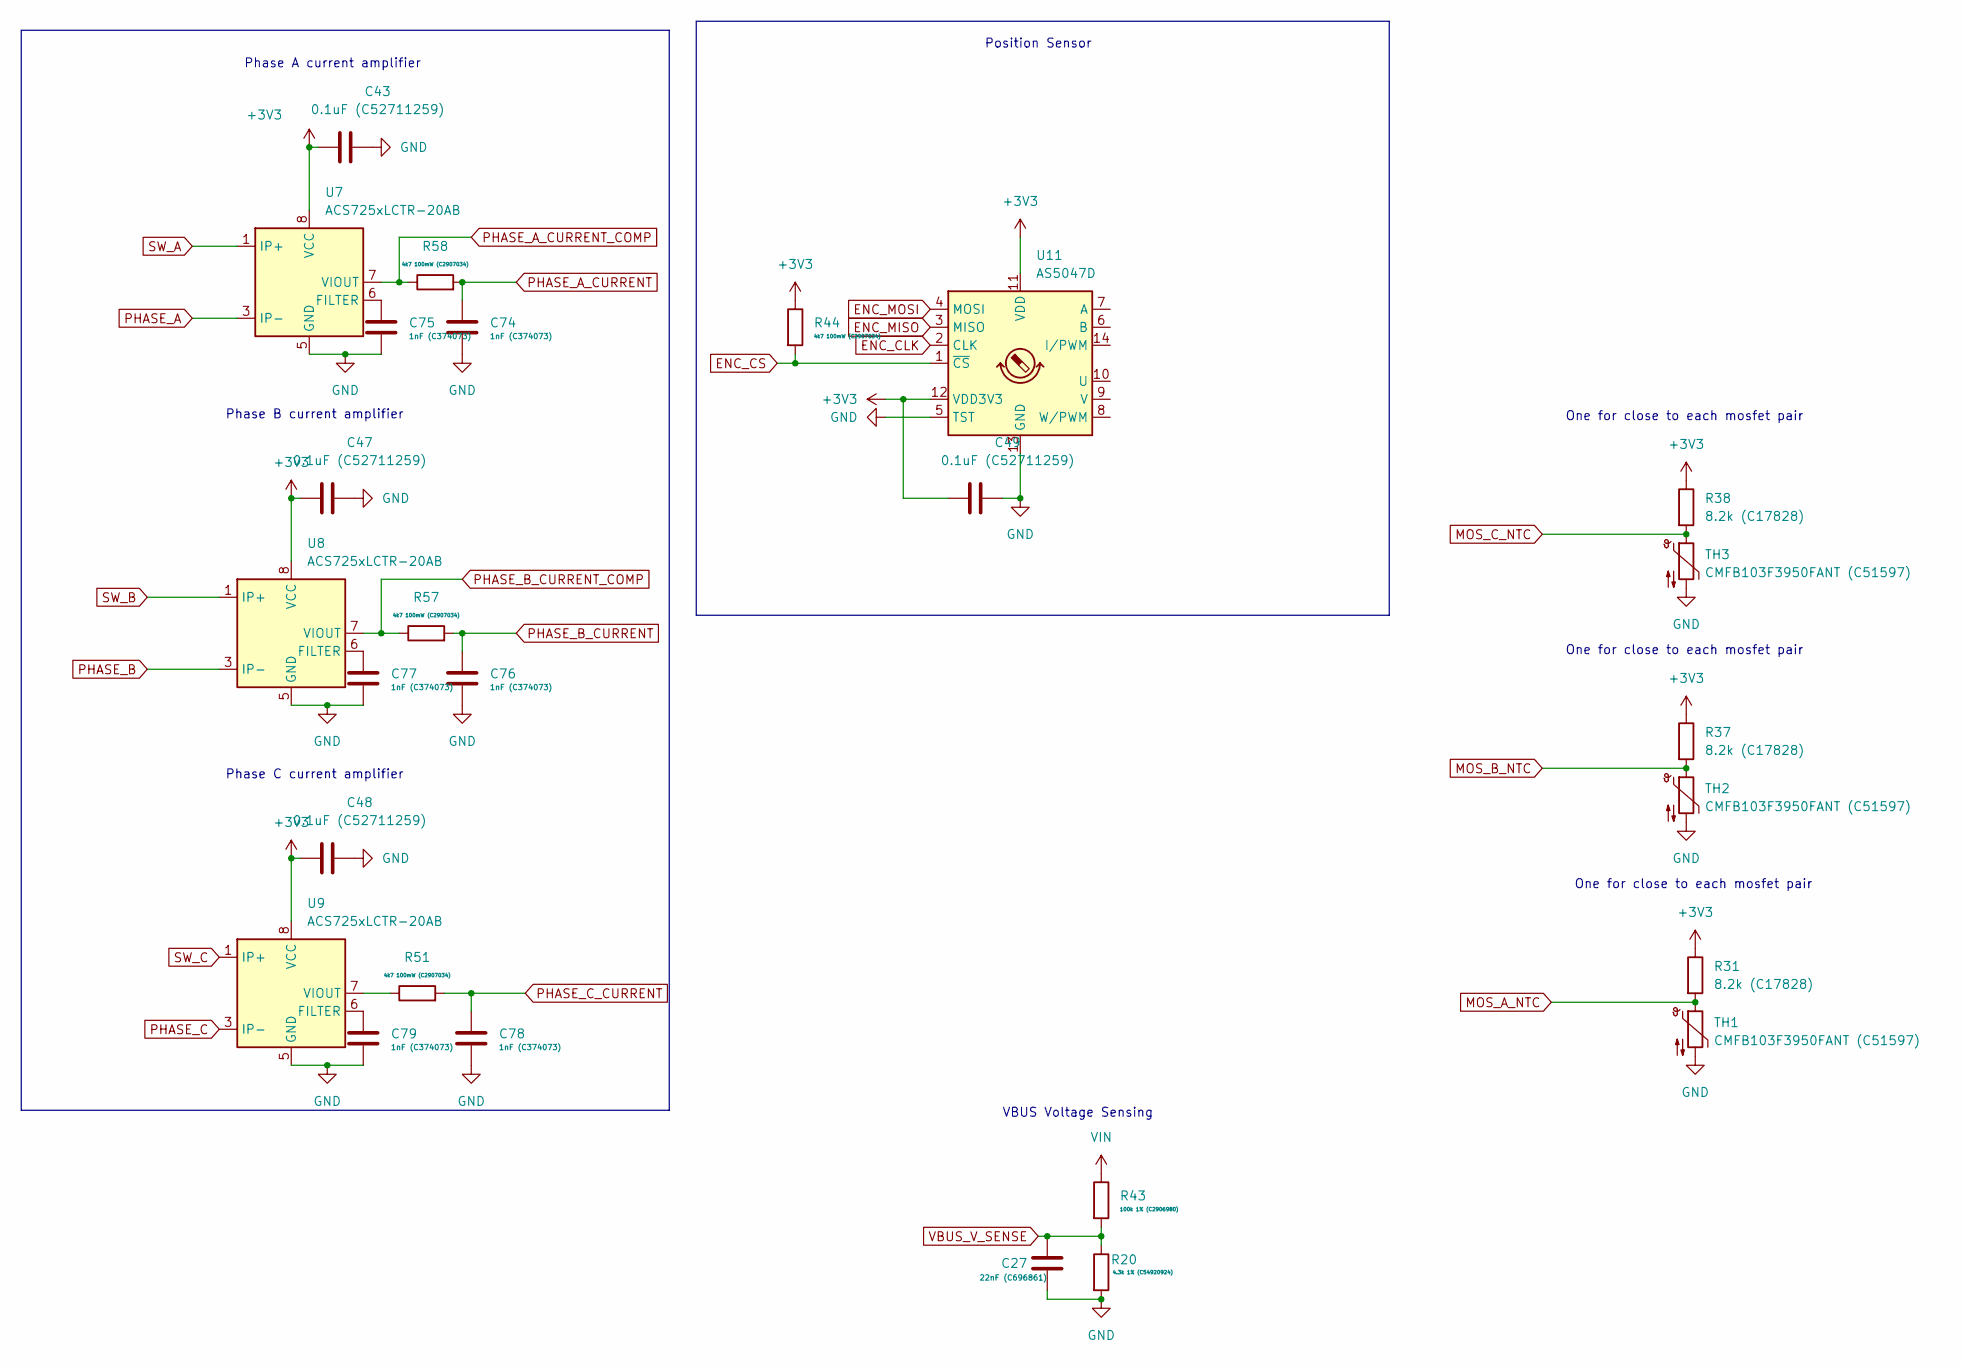
[picture p9: schematic STM32BLDCV3-Sensing.kicad_sch]

Parts:
C27: 22nF (C696861); C_0603_1608Metric_Pad1.08x0.95mm_HandSolder
C43, C47, C48, C49: 0.1uF (C52711259); C_0603_1608Metric_Pad1.08x0.95mm_HandSolder
C74, C75, C76, C77, C78, C79: 1nF (C374073); C_0603_1608Metric_Pad1.08x0.95mm_HandSolder
R20: 4.3k 1% (C54920924); R_0603_1608Metric_Pad0.98x0.95mm_HandSolder
R31, R37, R38: 8.2k (C17828); R_0805_2012Metric_Pad1.20x1.40mm_HandSolder
R43: 100k 1% (C2906980); R_0603_1608Metric_Pad0.98x0.95mm_HandSolder
R44: 4k7 100mW (C2907034); R_0201_0603Metric_Pad0.64x0.40mm_HandSolder
R51, R57, R58: 4k7 100mW (C2907034); R_0603_1608Metric_Pad0.98x0.95mm_HandSolder
TH1, TH2, TH3: CMFB103F3950FANT (C51597); R_0805_2012Metric_Pad1.20x1.40mm_HandSolder
U7, U8, U9: ACS725xLCTR-20AB; SOIC-8_3.9x4.9mm_P1.27mm
U11: AS5047D; TSSOP-14_4.4x5mm_P0.65mm

Connections:
+3V3: C43.1, C47.1, C48.1, C49.1, R31.1, R37.1, R38.1, R44.1, U7.8 (VCC), U8.8 (VCC), U9.8 (VCC), U11.11 (VDD), U11.12 (VDD3V3); also elsewhere on the board
ENC_CLK: U11.2 (CLK); also elsewhere on the board
ENC_CS: R44.2, U11.1 (~CS); also elsewhere on the board
ENC_MISO: U11.3 (MISO); also elsewhere on the board
ENC_MOSI: U11.4 (MOSI); also elsewhere on the board
GND: C27.2, C43.2, C47.2, C48.2, C49.2, C74.2, C75.2, C76.2, C77.2, C78.2, C79.2, R20.2, TH1.2, TH2.2, TH3.2, U7.5 (GND), U8.5 (GND), U9.5 (GND), U11.5 (TST), U11.13 (GND); also elsewhere on the board
MOS_A_NTC: R31.2, TH1.1; also elsewhere on the board
MOS_B_NTC: R37.2, TH2.1; also elsewhere on the board
MOS_C_NTC: R38.2, TH3.1; also elsewhere on the board
unnamed: C75.1, U7.6 (FILTER)
unnamed: C77.1, U8.6 (FILTER)
unnamed: C79.1, U9.6 (FILTER)
unnamed: R51.1, U9.7 (VIOUT)
PHASE_A: U7.3 (IP-), U7.4 (IP-); also elsewhere on the board
PHASE_A_CURRENT: C74.1, R58.2; also elsewhere on the board
PHASE_A_CURRENT_COMP: R58.1, U7.7 (VIOUT); also elsewhere on the board
PHASE_B: U8.3 (IP-), U8.4 (IP-); also elsewhere on the board
PHASE_B_CURRENT: C76.1, R57.2; also elsewhere on the board
PHASE_B_CURRENT_COMP: R57.1, U8.7 (VIOUT); also elsewhere on the board
PHASE_C: U9.3 (IP-), U9.4 (IP-); also elsewhere on the board
PHASE_C_CURRENT: C78.1, R51.2; also elsewhere on the board
SW_A: U7.1 (IP+), U7.2 (IP+); also elsewhere on the board
SW_B: U8.1 (IP+), U8.2 (IP+); also elsewhere on the board
SW_C: U9.1 (IP+), U9.2 (IP+); also elsewhere on the board
VBUS_V_SENSE: C27.1, R20.1, R43.2; also elsewhere on the board
VIN: R43.1; also elsewhere on the board

Notes on the sheet:
One for close to each mosfet pair
Position Sensor
Phase A current amplifier
Phase B current amplifier
Phase C current amplifier
VBUS Voltage Sensing
