FredrikLLarsen/STM32F411_DRV8302_FOC_PCBA/STM 32 - BLDC Driver V3/STM32 BLDC Driver V3/_restore_backup_2026-09-18T21-46-55-770/STM32 BLDC Driver V3.kicad_pcb

## KiCad design STM 32 - BLDC Driver V3/STM32 BLDC Driver V3/_restore_backup_2026-09-18T21-46-55-770/STM32 BLDC Driver V3.kicad_pcb (continued)

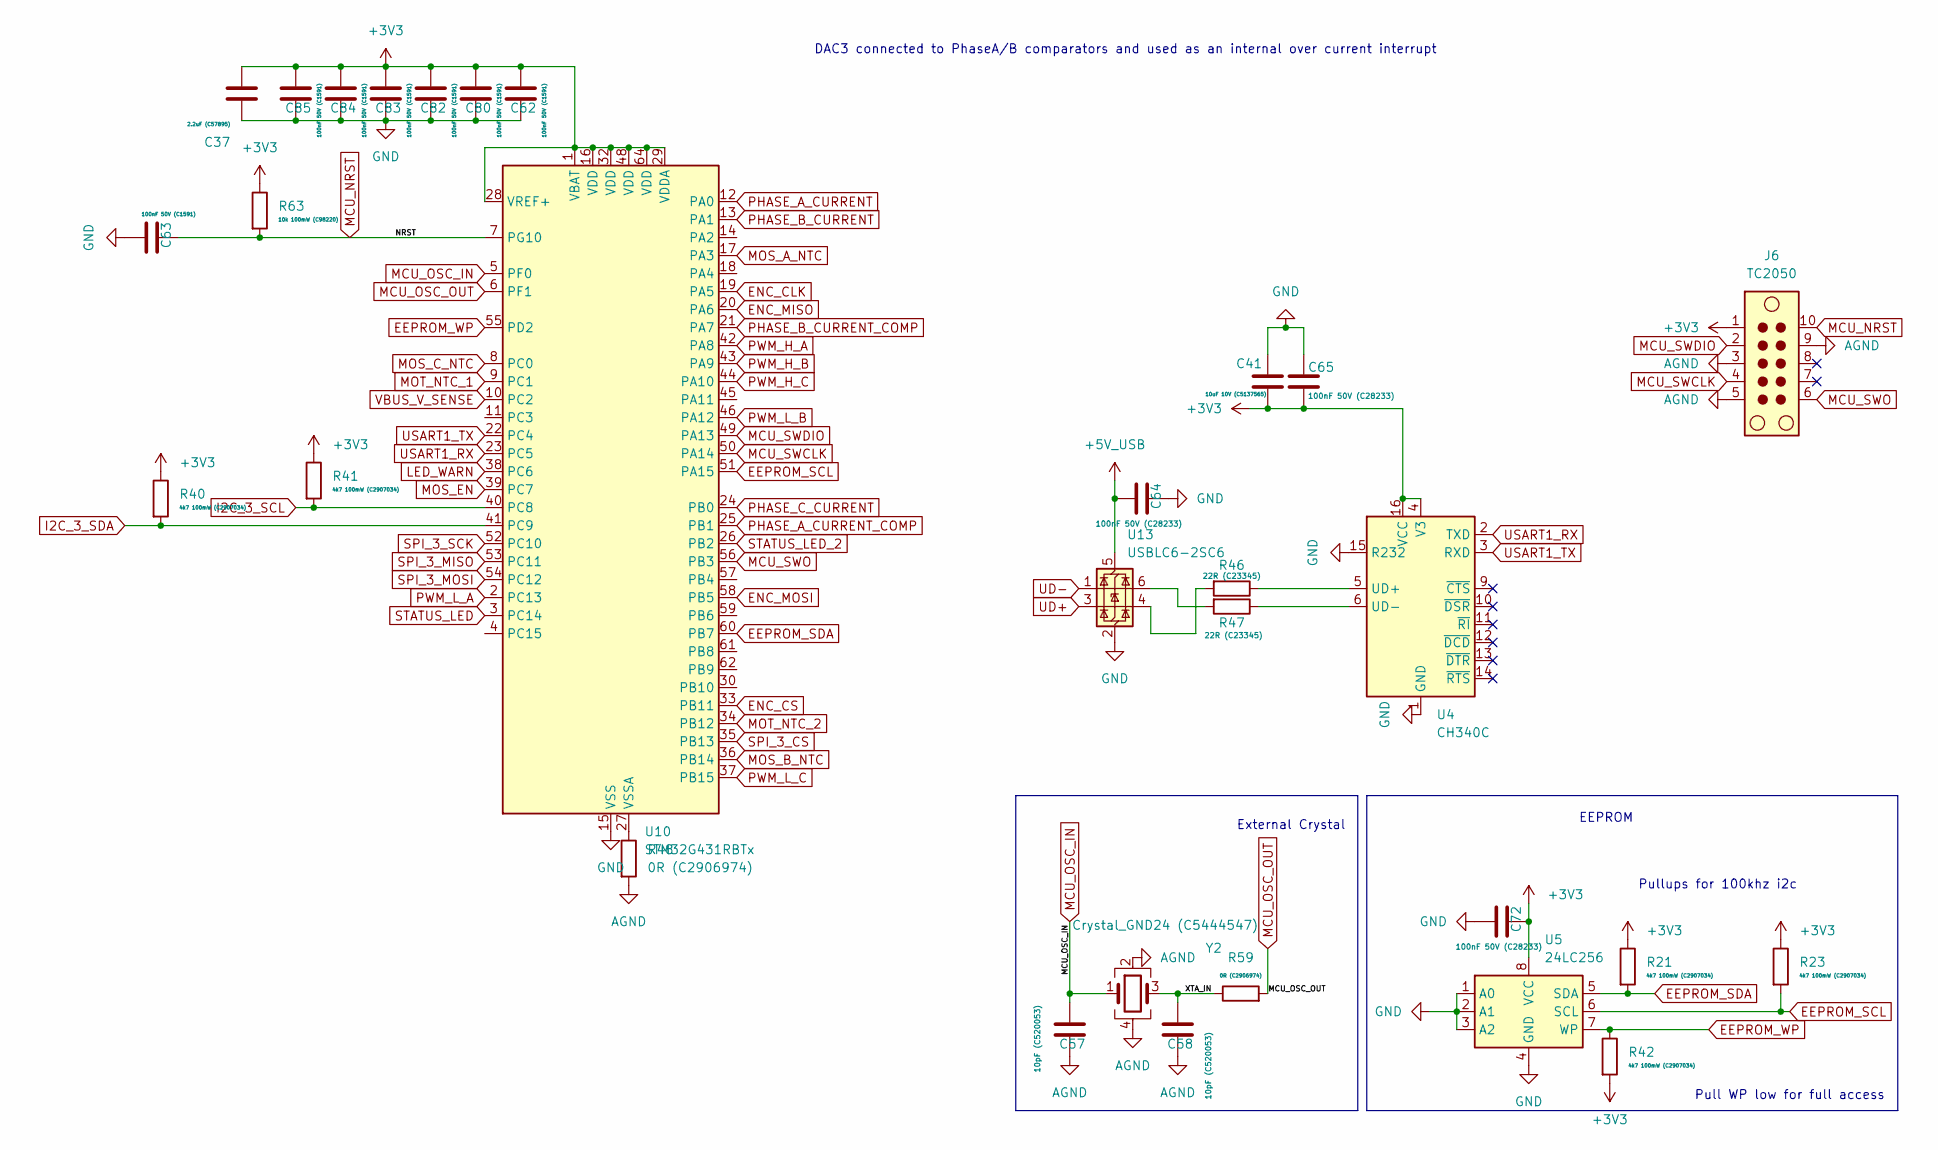
[picture p10: schematic MCU.kicad_sch]

Parts:
C37: 2.2uF (C57895); C_0603_1608Metric_Pad1.08x0.95mm_HandSolder
C41: 10uF 10V (C5137565); C_0603_1608Metric_Pad1.08x0.95mm_HandSolder
C57, C58: 10pF (C520053); C_0805_2012Metric_Pad1.18x1.45mm_HandSolder
C62, C63, C80, C82, C83, C84, C85: 100nF 50V (C1591); C_0603_1608Metric_Pad1.08x0.95mm_HandSolder
C64, C65, C72: 100nF 50V (C28233); C_0805_2012Metric_Pad1.18x1.45mm_HandSolder
J6: TC2050; Tag-Connect_TC2050-IDC-NL_2x05_P1.27mm_Vertical
R21, R23, R40, R41, R42: 4k7 100mW (C2907034); R_0603_1608Metric_Pad0.98x0.95mm_HandSolder
R46, R47: 22R (C23345); R_0603_1608Metric_Pad0.98x0.95mm_HandSolder
R48, R59: 0R (C2906974); R_0603_1608Metric_Pad0.98x0.95mm_HandSolder
R63: 10k 100mW (C98220); R_0603_1608Metric_Pad0.98x0.95mm_HandSolder
U4: CH340C; SOIC-16_3.9x9.9mm_P1.27mm
U5: 24LC256; SOIC-8_3.9x4.9mm_P1.27mm
U10: STM32G431RBTx; LQFP-64_10x10mm_P0.5mm
U13: USBLC6-2SC6; SOT-23-6
Y2: Crystal_GND24 (C5444547); Crystal_SMD_3225-4Pin_3.2x2.5mm_HandSoldering

Connections:
+3V3: C37.2, C41.1, C62.2, C65.2, C72.1, C80.2, C82.2, C83.2, C84.2, C85.2, J6.1, R21.1, R23.1, R40.1, R41.1, R42.2, R63.1, U4.4 (V3), U4.16 (VCC), U5.8 (VCC), U10.1 (VBAT), U10.16 (VDD), U10.28 (VREF+), U10.29 (VDDA), U10.32 (VDD), U10.48 (VDD), U10.64 (VDD); also elsewhere on the board
+5V_USB: C64.2, U13.5 (VBUS); also elsewhere on the board
/MCU/XTA_IN: C58.2, R59.1, Y2.3
AGND: C57.1, C58.1, J6.3, J6.5, J6.9, R48.2, Y2.2, Y2.4; also elsewhere on the board
EEPROM_SCL: R23.2, U5.6 (SCL), U10.51 (PA15)
EEPROM_SDA: R21.2, U5.5 (SDA), U10.60 (PB7)
EEPROM_WP: R42.1, U5.7 (WP), U10.55 (PD2)
ENC_CLK: U10.19 (PA5); also elsewhere on the board
ENC_CS: U10.33 (PB11); also elsewhere on the board
ENC_MISO: U10.20 (PA6); also elsewhere on the board
ENC_MOSI: U10.58 (PB5); also elsewhere on the board
GND: C37.1, C41.2, C62.1, C63.2, C64.1, C65.1, C72.2, C80.1, C82.1, C83.1, C84.1, C85.1, U4.1 (GND), U4.15 (R232), U5.1 (A0), U5.2 (A1), U5.3 (A2), U5.4 (GND), U10.15 (VSS), U10.31 (VSS), U10.47 (VSS), U10.63 (VSS), U13.2 (GND); also elsewhere on the board
I2C_3_SCL: R41.2, U10.40 (PC8); also elsewhere on the board
I2C_3_SDA: R40.2, U10.41 (PC9); also elsewhere on the board
LED_WARN: U10.38 (PC6); also elsewhere on the board
MCU_NRST: C63.1, J6.10, R63.2, U10.7 (PG10)
MCU_OSC_IN: C57.2, U10.5 (PF0), Y2.1
MCU_OSC_OUT: R59.2, U10.6 (PF1)
MCU_SWCLK: J6.4, U10.50 (PA14)
MCU_SWDIO: J6.2, U10.49 (PA13)
MCU_SWO: J6.6, U10.56 (PB3)
MOS_A_NTC: U10.17 (PA3); also elsewhere on the board
MOS_B_NTC: U10.36 (PB14); also elsewhere on the board
MOS_C_NTC: U10.8 (PC0); also elsewhere on the board
MOS_EN: U10.39 (PC7); also elsewhere on the board
MOT_NTC_1: U10.9 (PC1)
MOT_NTC_2: U10.34 (PB12)
unnamed: R46.2, U13.4 (I/O2)
unnamed: R47.2, U13.6 (I/O1)
unnamed: R46.1, U4.5 (UD+)
unnamed: R47.1, U4.6 (UD-)
unnamed: R48.1, U10.27 (VSSA)
PHASE_A_CURRENT: U10.12 (PA0); also elsewhere on the board
PHASE_A_CURRENT_COMP: U10.25 (PB1); also elsewhere on the board
PHASE_B_CURRENT: U10.13 (PA1); also elsewhere on the board
PHASE_B_CURRENT_COMP: U10.21 (PA7); also elsewhere on the board
PHASE_C_CURRENT: U10.24 (PB0); also elsewhere on the board
PWM_H_A: U10.42 (PA8); also elsewhere on the board
PWM_H_B: U10.43 (PA9); also elsewhere on the board
PWM_H_C: U10.44 (PA10); also elsewhere on the board
PWM_L_A: U10.2 (PC13); also elsewhere on the board
PWM_L_B: U10.46 (PA12); also elsewhere on the board
PWM_L_C: U10.37 (PB15); also elsewhere on the board
SPI_3_CS: U10.35 (PB13); also elsewhere on the board
SPI_3_MISO: U10.53 (PC11); also elsewhere on the board
SPI_3_MOSI: U10.54 (PC12); also elsewhere on the board
SPI_3_SCK: U10.52 (PC10); also elsewhere on the board
STATUS_LED: U10.3 (PC14); also elsewhere on the board
STATUS_LED_2: U10.26 (PB2); also elsewhere on the board
UD+: U13.3 (I/O2); also elsewhere on the board
UD-: U13.1 (I/O1); also elsewhere on the board
USART1_RX: U4.2 (TXD), U10.23 (PC5)
USART1_TX: U4.3 (RXD), U10.22 (PC4)
VBUS_V_SENSE: U10.10 (PC2); also elsewhere on the board

Notes on the sheet:
External Crystal
EEPROM
Pull WP low for full access
DAC3 connected to PhaseA/B comparators and used as an internal over current interrupt
Pullups for 100khz i2c

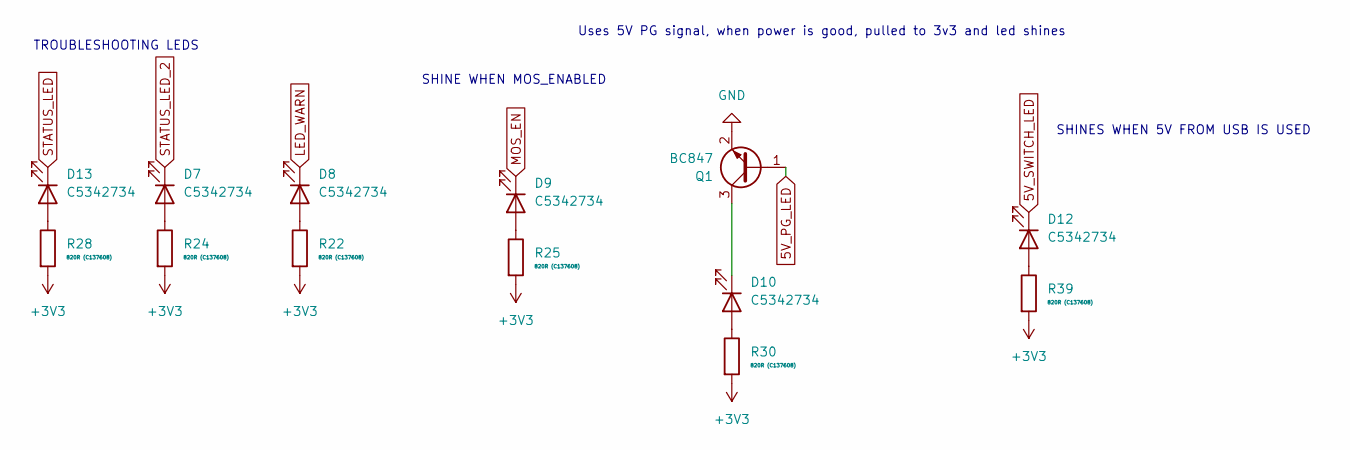
[picture p11: schematic STATUS INDICATION.kicad_sch]

Parts:
D7, D8, D9, D10, D12, D13: C5342734; LED_0603_1608Metric_Pad1.05x0.95mm_HandSolder
Q1: BC847; SOT-23
R22, R24, R25, R28, R30, R39: 820R (C137608); R_0603_1608Metric_Pad0.98x0.95mm_HandSolder

Connections:
5V_PG_LED: Q1.1 (B); also elsewhere on the board
5V_SWITCH_LED: D12.1 (K); also elsewhere on the board
+3V3: R22.2, R24.2, R25.2, R28.2, R30.2, R39.2; also elsewhere on the board
GND: Q1.2 (E); also elsewhere on the board
LED_WARN: D8.1 (K); also elsewhere on the board
MOS_EN: D9.1 (K); also elsewhere on the board
unnamed: D7.2 (A), R24.1
unnamed: D8.2 (A), R22.1
unnamed: D9.2 (A), R25.1
unnamed: D10.2 (A), R30.1
unnamed: D10.1 (K), Q1.3 (C)
unnamed: D12.2 (A), R39.1
unnamed: D13.2 (A), R28.1
STATUS_LED: D13.1 (K); also elsewhere on the board
STATUS_LED_2: D7.1 (K); also elsewhere on the board

Notes on the sheet:
TROUBLESHOOTING LEDS
Uses 5V PG signal, when power is good, pulled to 3v3 and led shines
SHINE WHEN MOS_ENABLED
SHINES WHEN 5V FROM USB IS USED

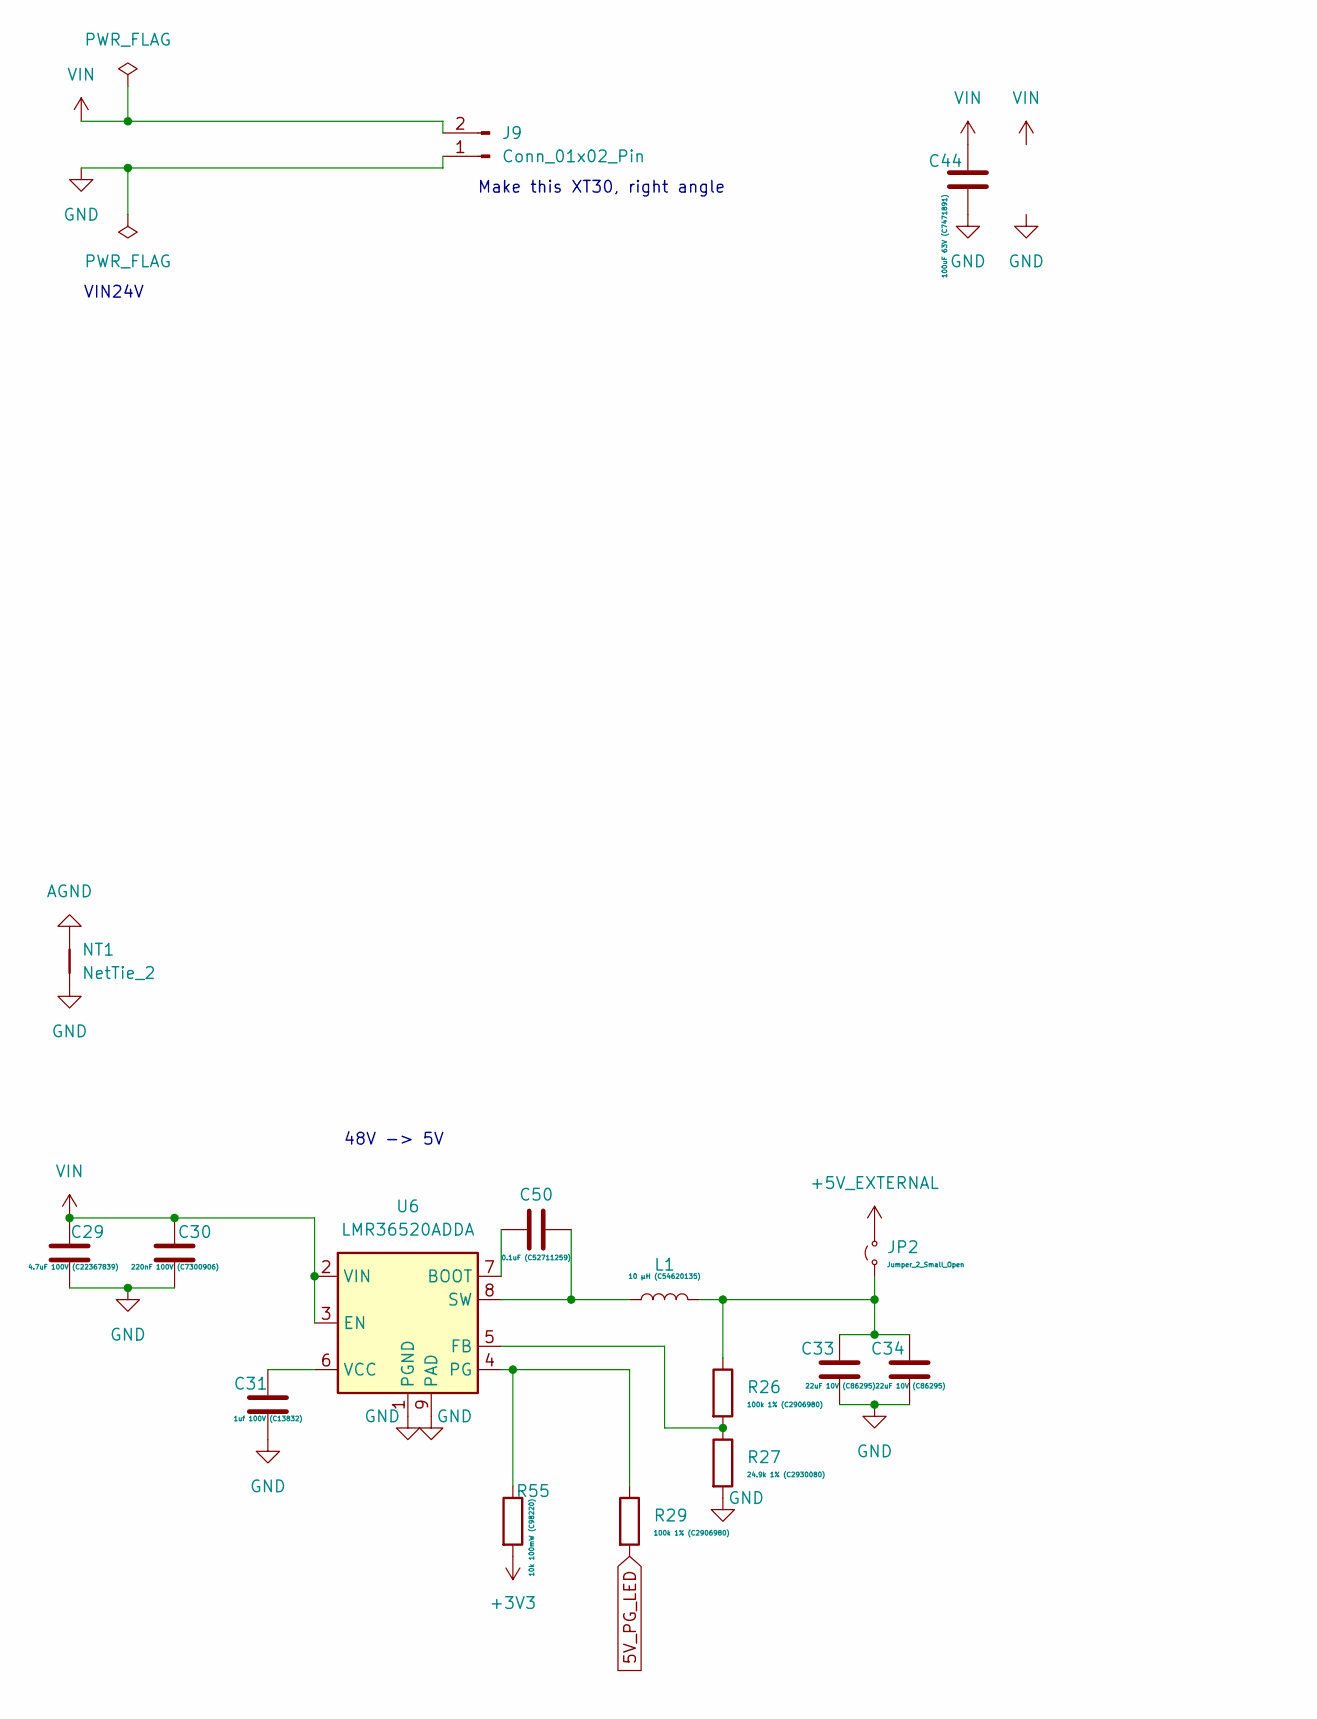
[picture p12: schematic STM32BLDCV3_POWER.kicad_sch, part in row 1, column 1]

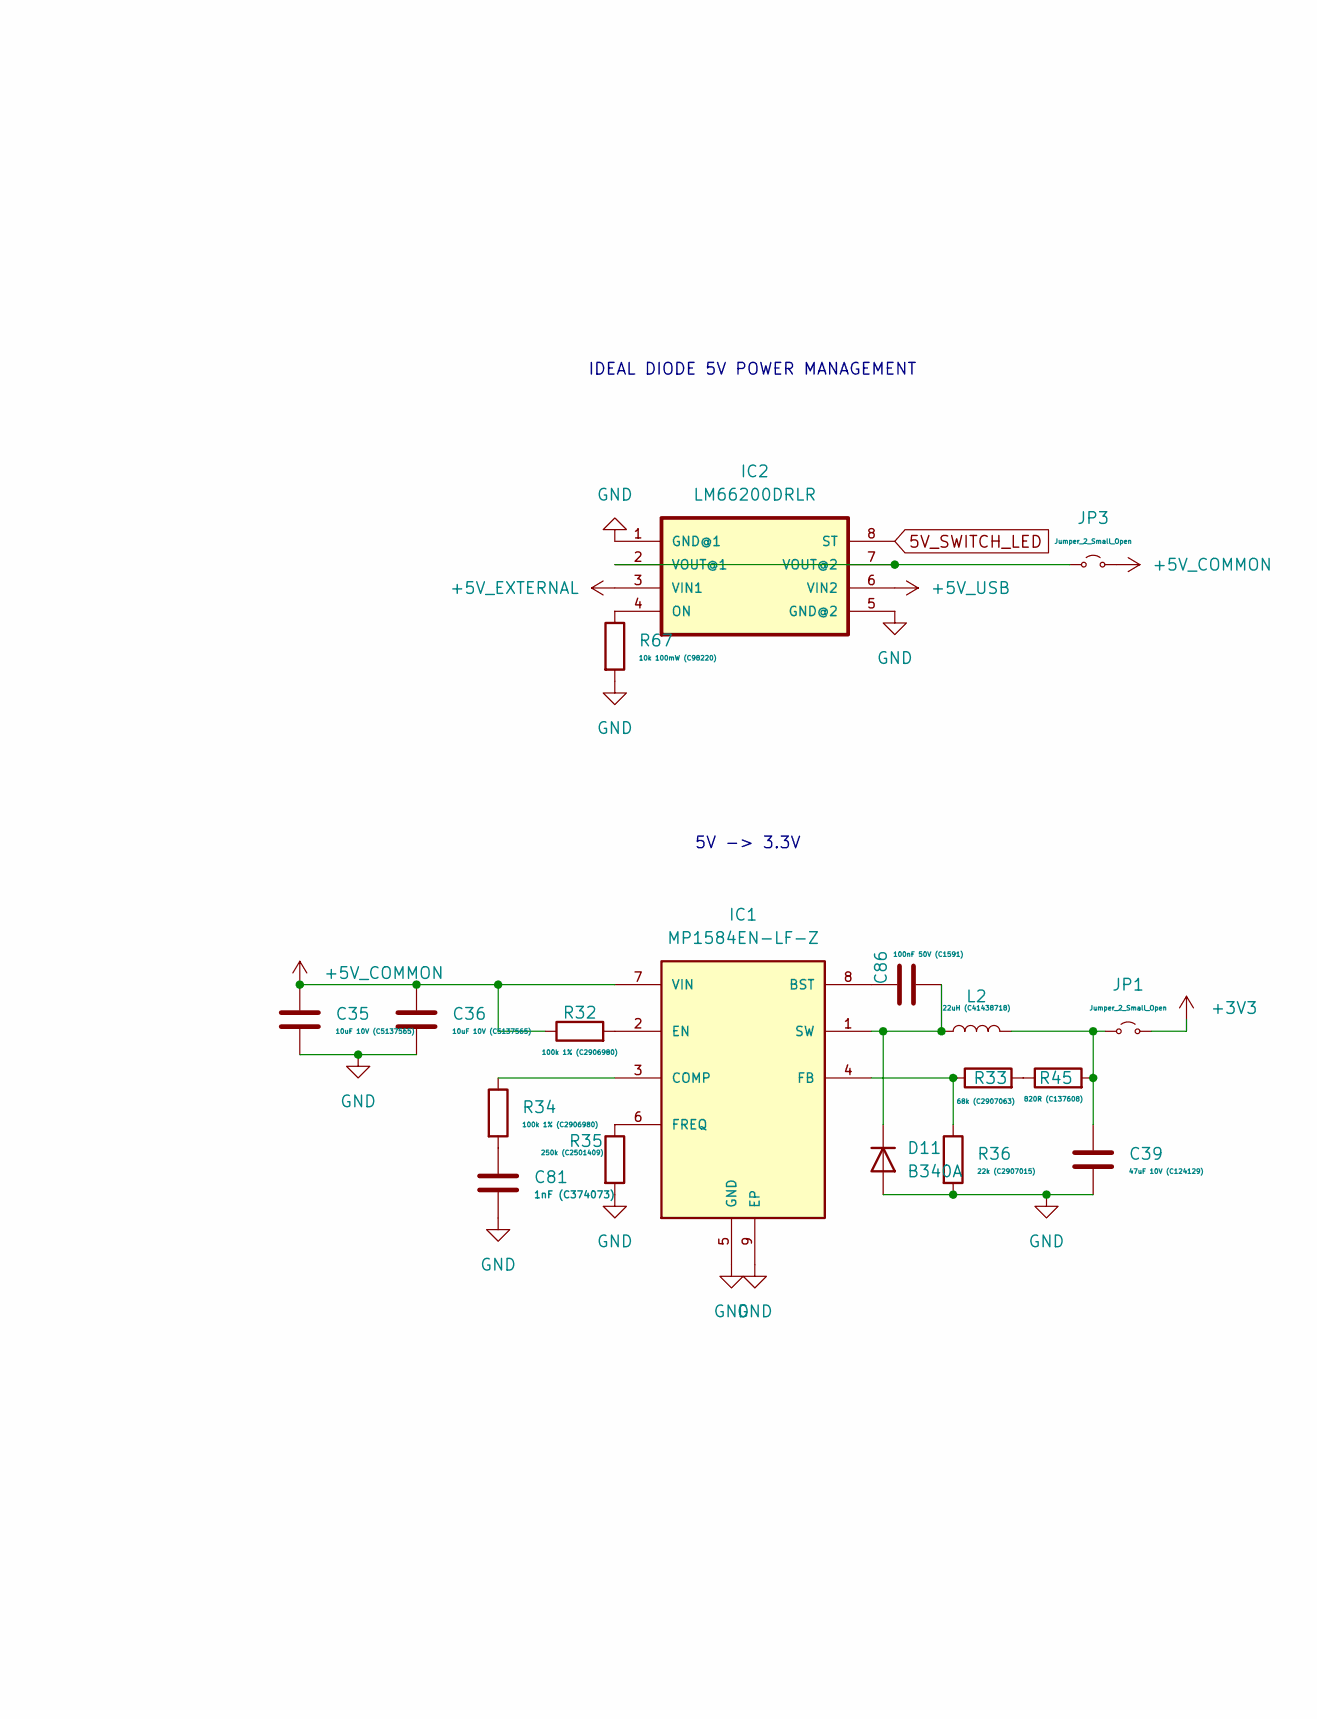
[picture p13: schematic STM32BLDCV3_POWER.kicad_sch, part in row 1, column 2]

Parts:
C29: 4.7uF 100V (C22367839); C_1206_3216Metric_Pad1.33x1.80mm_HandSolder
C30: 220nF 100V (C7300906); C_0603_1608Metric_Pad1.08x0.95mm_HandSolder
C31: 1uf 100V (C13832); C_1206_3216Metric_Pad1.33x1.80mm_HandSolder
C33, C34: 22uF 10V (C86295); C_0603_1608Metric_Pad1.08x0.95mm_HandSolder
C35, C36: 10uF 10V (C5137565); C_0603_1608Metric_Pad1.08x0.95mm_HandSolder
C39: 47uF 10V (C124129); C_0805_2012Metric_Pad1.18x1.45mm_HandSolder
C44: 100uF 63V (C7471891); C_Elec_8x10.2
C50: 0.1uF (C52711259); C_0603_1608Metric_Pad1.08x0.95mm_HandSolder
C81: 1nF (C374073); C_0603_1608Metric_Pad1.08x0.95mm_HandSolder
C86: 100nF 50V (C1591); C_0603_1608Metric_Pad1.08x0.95mm_HandSolder
D11: B340A; D_SMA_Handsoldering
IC1: MP1584EN-LF-Z; SOIC127P600X170-9N; MOUSER_PART_NUMBER 946-MP1584ENLFZ
IC2: LM66200DRLR; SOT8
J9: Conn_01x02_Pin; Molex_Nano-Fit_105313-xx02_1x02_P2.50mm_Horizontal
JP1, JP2, JP3: Jumper_2_Small_Open; SolderJumper-2_P1.3mm_Open_RoundedPad1.0x1.5mm
L1: 10 µH (C54620135); L_Abracon_ASPIAIG-F4020
L2: 22uH (C41438718); L_Sunlord_MWSA0402S
NT1: NetTie_2; NetTie-2_SMD_Pad0.5mm
R26, R29, R32, R34: 100k 1% (C2906980); R_0603_1608Metric_Pad0.98x0.95mm_HandSolder
R27: 24.9k 1% (C2930080); R_0603_1608Metric_Pad0.98x0.95mm_HandSolder
R33: 68k (C2907063); R_0603_1608Metric_Pad0.98x0.95mm_HandSolder
R35: 250k (C2501409); R_0805_2012Metric_Pad1.20x1.40mm_HandSolder
R36: 22k (C2907015); R_0603_1608Metric_Pad0.98x0.95mm_HandSolder
R45: 820R (C137608); R_0603_1608Metric_Pad0.98x0.95mm_HandSolder
R55, R67: 10k 100mW (C98220); R_0603_1608Metric_Pad0.98x0.95mm_HandSolder
U6: LMR36520ADDA; Texas_HTSOP-8-1EP_3.9x4.9mm_P1.27mm_EP2.95x4.9mm_Mask2.4x3.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

Connections:
5V_PG_LED: R29.2; also elsewhere on the board
5V_SWITCH_LED: IC2.8 (ST); also elsewhere on the board
+3V3: JP1.2 (B), R55.2; also elsewhere on the board
+5V_COMMON: C35.2, C36.2, IC1.7 (VIN), JP3.2 (B), R32.1; also elsewhere on the board
+5V_EXTERNAL: IC2.3 (VIN1), JP2.2 (B)
+5V_USB: IC2.6 (VIN2); also elsewhere on the board
AGND: NT1.2; also elsewhere on the board
GND: C29.2, C30.2, C31.2, C33.1, C34.1, C35.1, C36.1, C39.1, C44.1, C81.2, D11.2 (A), IC1.5 (GND), IC1.9 (EP), IC2.1 (GND@1), IC2.5 (GND@2), J9.1, NT1.1, R27.2, R35.2, R36.2, R67.2, U6.1 (PGND), U6.9 (PAD); also elsewhere on the board
unnamed: C81.1, R34.2
unnamed: C86.1, D11.1 (K), IC1.1 (SW), L2.1
unnamed: C86.2, IC1.8 (BST)
unnamed: IC1.3 (COMP), R34.1
unnamed: IC1.2 (EN), R32.2
unnamed: IC1.4 (FB), R33.1, R36.1
unnamed: IC1.6 (FREQ), R35.1
unnamed: IC2.4 (ON), R67.1
unnamed: IC2.2 (VOUT@1), IC2.7 (VOUT@2), JP3.1 (A)
unnamed: C39.2, JP1.1 (A), L2.2, R45.2
unnamed: C33.2, C34.2, JP2.1 (A), L1.2, R26.1
unnamed: R33.2, R45.1
unnamed: C50.1, U6.7 (BOOT)
unnamed: R26.2, R27.1, U6.5 (FB)
unnamed: R29.1, R55.1, U6.4 (PG)
unnamed: C50.2, L1.1, U6.8 (SW)
unnamed: C31.1, U6.6 (VCC)
VIN: C29.1, C30.1, C44.2, J9.2, U6.2 (VIN), U6.3 (EN); also elsewhere on the board

Notes on the sheet:
5V -> 3.3V
48V -> 5V
VIN24V
IDEAL DIODE 5V POWER MANAGEMENT
Make this XT30, right angle

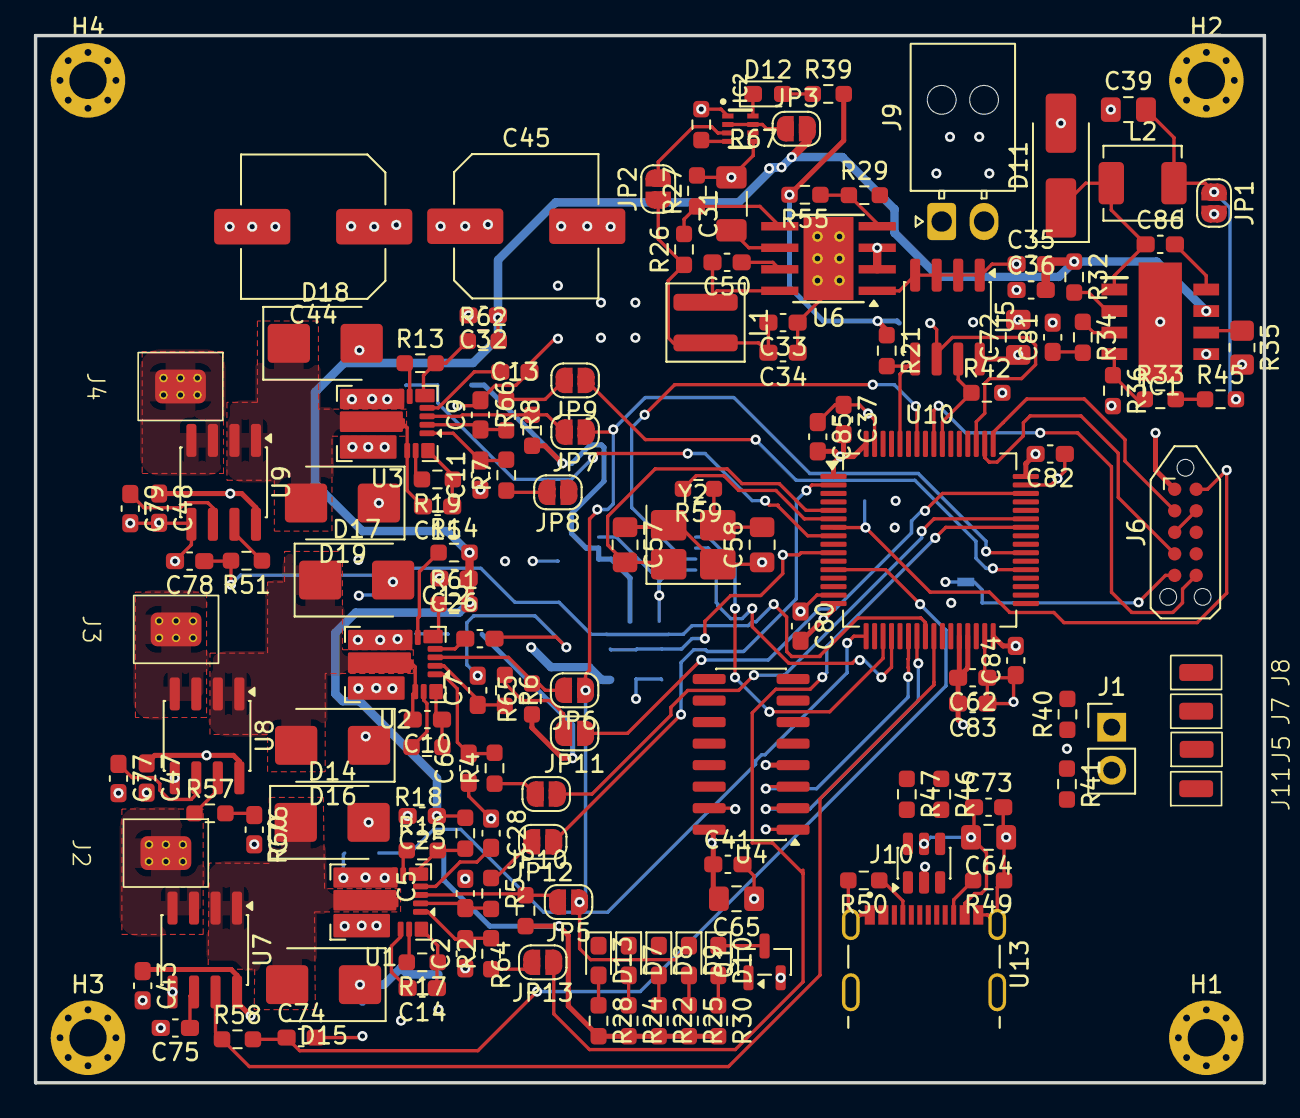
[picture p14: board STM32 BLDC Driver V3.kicad_pcb from above]

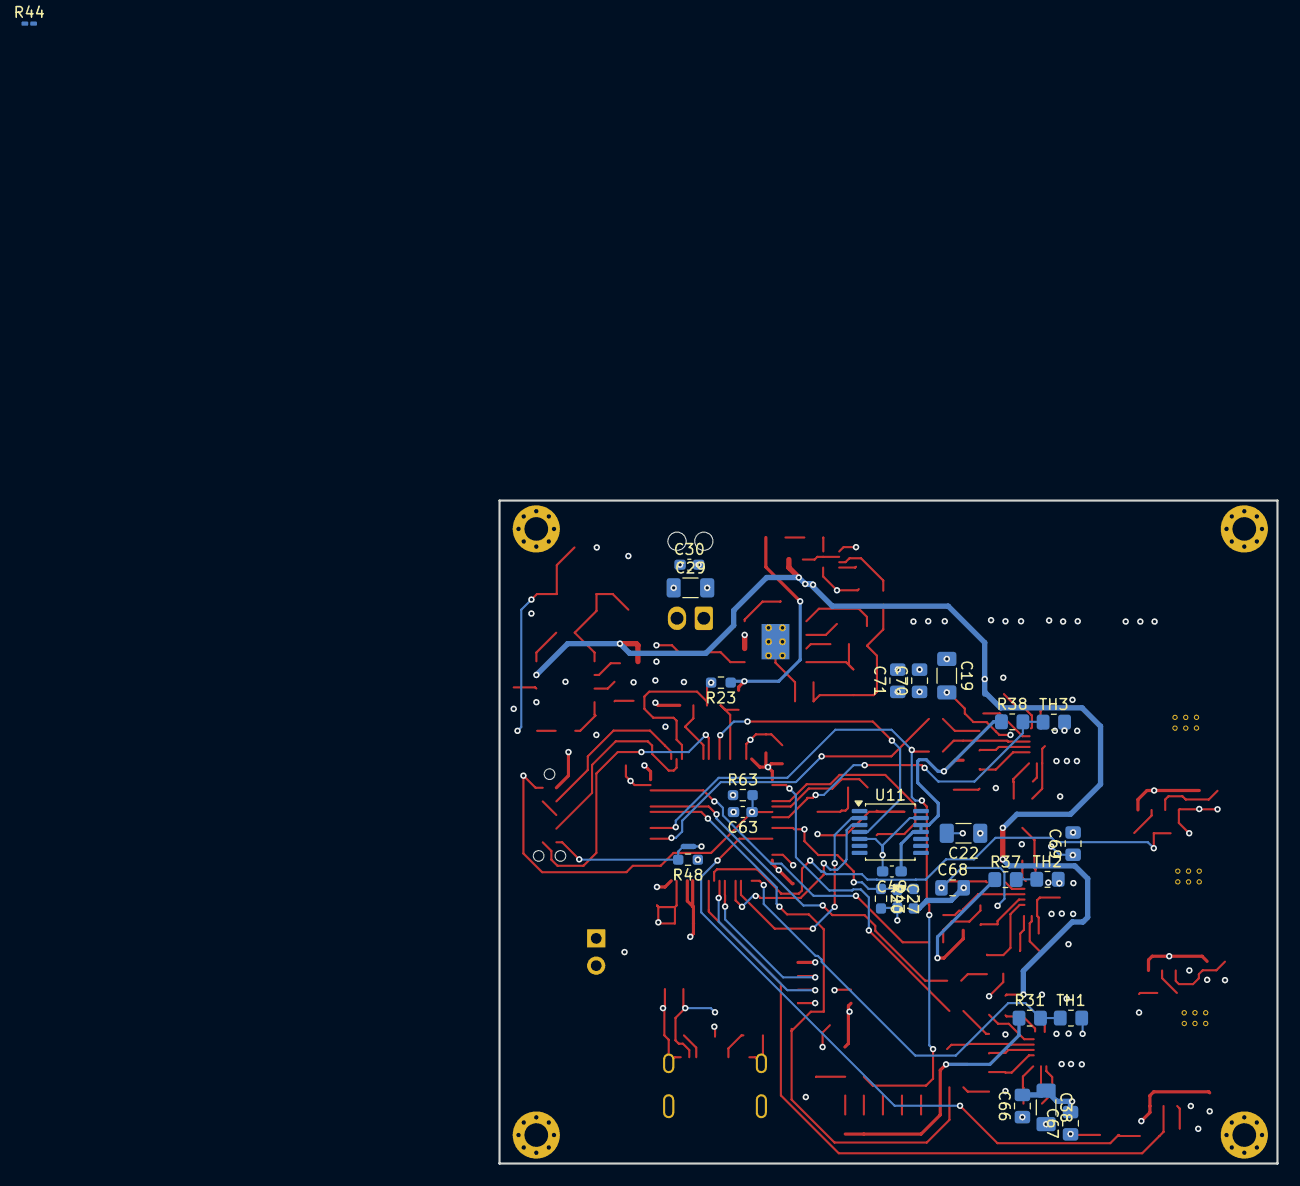
[picture p15: board STM32 BLDC Driver V3.kicad_pcb from below]

Board: 4 copper layers, 72.5 x 61.8 mm, 181 parts (28 on the bottom side), 123 nets.

Other parts of the board:
C45: 100uF 63V (C7471891); C_Elec_8x10.2

Their connections:
GND: C45.1; also elsewhere on the board
VIN: C45.2; also elsewhere on the board
