FredrikLLarsen/STM32F411_DRV8302_FOC_PCBA/STM32 - BLDC Driver/FL50-15 Adapter/FL50-15 Adapter.kicad_pcb

## KiCad design STM32 - BLDC Driver/FL50-15 Adapter/FL50-15 Adapter.kicad_pcb (2026-10-09)

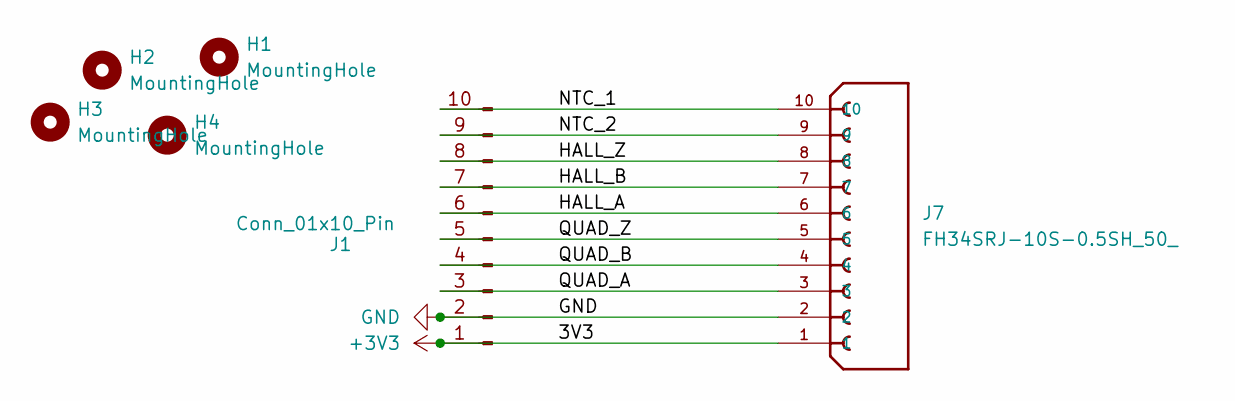
[picture p16: schematic FL50-15 Adapter.kicad_sch]

Parts:
H1, H2, H3, H4: MountingHole; MountingHole_3.2mm_M3
J1: Conn_01x10_Pin; PinHeader_1x10_P2.54mm_Vertical
J7: FH34SRJ-10S-0.5SH_50_; HRS_FH34SRJ-10S-0.5SH_50_; PARTREV Apr.1.2022

Connections:
+3V3: J1.1, J7.1
/HALL_A: J1.6, J7.6
/HALL_B: J1.7, J7.7
/HALL_Z: J1.8, J7.8
/NTC_1: J1.10, J7.10
/NTC_2: J1.9, J7.9
/QUAD_A: J1.3, J7.3
/QUAD_B: J1.4, J7.4
/QUAD_Z: J1.5, J7.5
GND: J1.2, J7.2

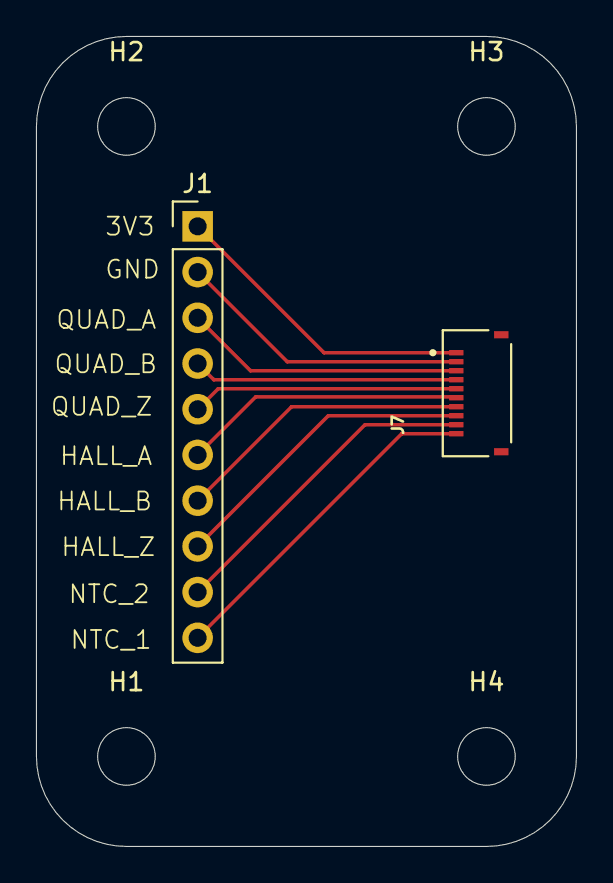
[picture p17: board FL50-15 Adapter.kicad_pcb from above]

Board: 2 copper layers, 30.0 x 45.0 mm, 6 parts (0 on the bottom side), 10 nets.
