FredrikLLarsen/STM32F411_DRV8302_FOC_PCBA/STM32 - BLDC Driver/STM32 - BLDC Driver.kicad_pcb

## KiCad design STM32 - BLDC Driver/STM32 - BLDC Driver.kicad_pcb (2026-10-09)

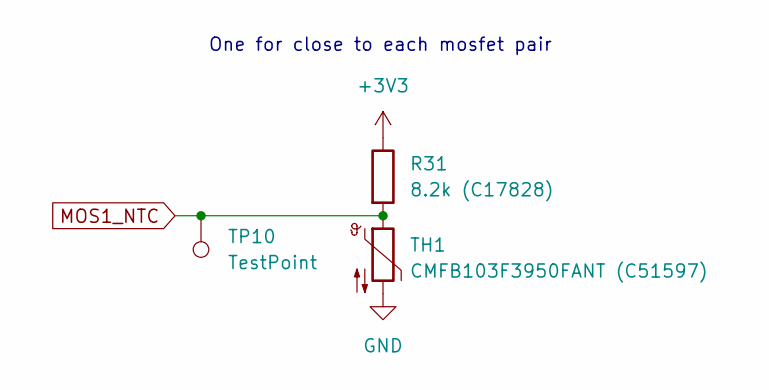
[picture p18: schematic Sensors.kicad_sch]

Parts:
R31: 8.2k (C17828); R_0805_2012Metric_Pad1.20x1.40mm_HandSolder
TH1: CMFB103F3950FANT (C51597); R_0805_2012Metric_Pad1.20x1.40mm_HandSolder
TP10: TestPoint; TestPoint_Pad_D3.0mm

Connections:
+3V3: R31.1; also elsewhere on the board
GND: TH1.2; also elsewhere on the board
MOS1_NTC: R31.2, TH1.1, TP10.1; also elsewhere on the board

Notes on the sheet:
One for close to each mosfet pair

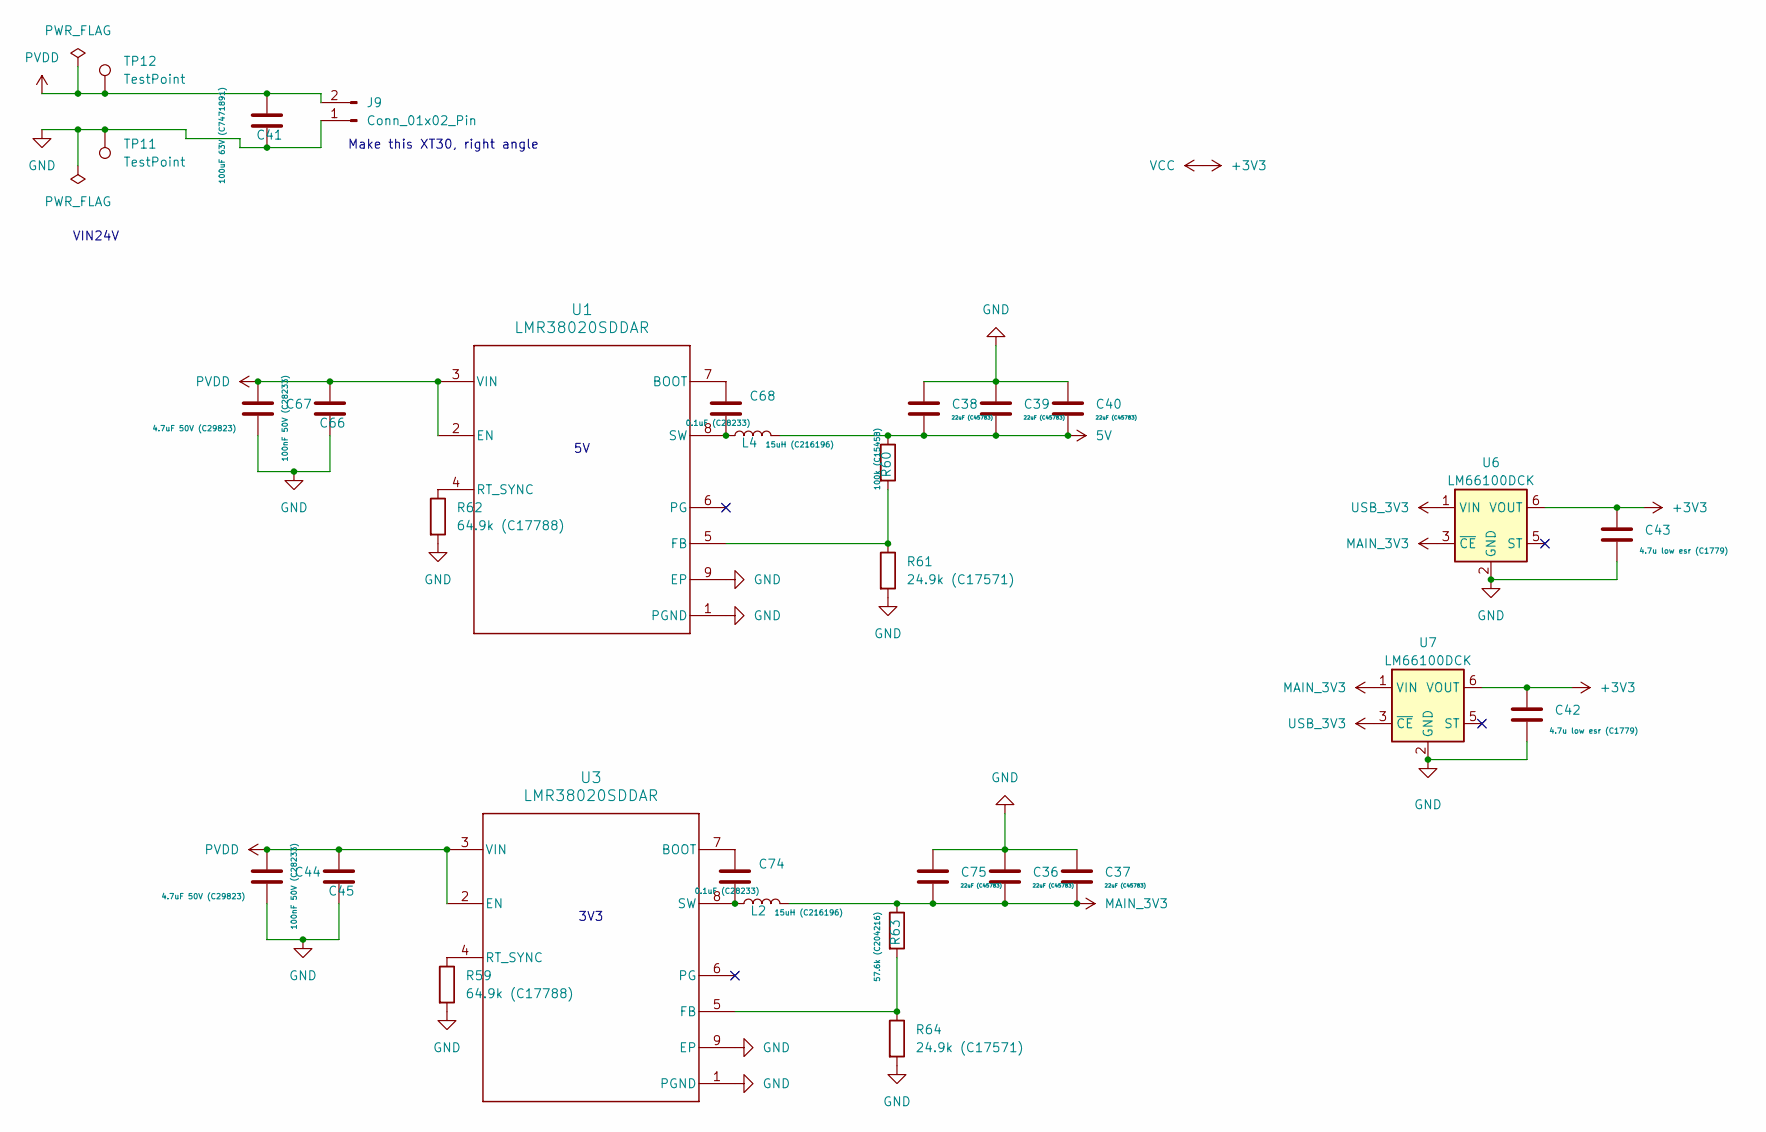
[picture p19: schematic untitled.kicad_sch]

Parts:
C36, C37, C38, C39, C40, C75: 22uF (C45783); C_0805_2012Metric_Pad1.18x1.45mm_HandSolder
C41: 100uF 63V (C7471891); C_Elec_8x10.2
C42, C43: 4.7u low esr (C1779); C_0805_2012Metric_Pad1.18x1.45mm_HandSolder
C44, C67: 4.7uF 50V (C29823); C_1206_3216Metric_Pad1.33x1.80mm_HandSolder
C45, C66: 100nF 50V (C28233); C_0805_2012Metric_Pad1.18x1.45mm_HandSolder
C68, C74: 0.1uF (C28233); C_0805_2012Metric_Pad1.18x1.45mm_HandSolder
J9: Conn_01x02_Pin; AMASS_XT30PW-M_1x02_P2.50mm_Horizontal
L2, L4: 15uH (C216196); L_7.3x7.3_H3.5
R59, R62: 64.9k (C17788); R_0805_2012Metric_Pad1.20x1.40mm_HandSolder
R60: 100k (C15458); R_0603_1608Metric_Pad0.98x0.95mm_HandSolder
R61, R64: 24.9k (C17571); R_0805_2012Metric_Pad1.20x1.40mm_HandSolder
R63: 57.6k (C204216); R_0603_1608Metric_Pad0.98x0.95mm_HandSolder
TP11, TP12: TestPoint; TestPoint_Pad_D4.0mm
U1, U3: LMR38020SDDAR; DDA0008E-IPC_A
U6, U7: LM66100DCK; SOT-363_SC-70-6

Connections:
5V: C38.2, C39.2, C40.2, L4.2, R60.1; also elsewhere on the board
+3V3: C42.1, C43.1, U6.6 (VOUT), U7.6 (VOUT); also elsewhere on the board
GND: C36.1, C37.1, C38.1, C39.1, C40.1, C41.1, C42.2, C43.2, C44.2, C45.1, C66.1, C67.2, C75.1, J9.1, R59.2, R61.2, R62.2, R64.2, TP11.1, U1.1 (PGND), U1.9 (EP), U3.1 (PGND), U3.9 (EP), U6.2 (GND), U7.2 (GND); also elsewhere on the board
MAIN_3V3: C36.2, C37.2, C75.2, L2.2, R63.1, U6.3 (~CE), U7.1 (VIN)
unnamed: C68.1, U1.7 (BOOT)
unnamed: R60.2, R61.1, U1.5 (FB)
unnamed: R62.1, U1.4 (RT_SYNC)
unnamed: C68.2, L4.1, U1.8 (SW)
unnamed: C74.1, U3.7 (BOOT)
unnamed: R63.2, R64.1, U3.5 (FB)
unnamed: R59.1, U3.4 (RT_SYNC)
unnamed: C74.2, L2.1, U3.8 (SW)
PVDD: C41.2, C44.1, C45.2, C66.2, C67.1, J9.2, TP12.1, U1.2 (EN), U1.3 (VIN), U3.2 (EN), U3.3 (VIN); also elsewhere on the board
USB_3V3: U6.1 (VIN), U7.3 (~CE); also elsewhere on the board

Notes on the sheet:
Make this XT30, right angle
3V3
VIN24V
