FredrikLLarsen/STM32F411_DRV8302_FOC_PCBA/STM32 - BLDC Driver/STM32 - BLDC Driver.kicad_pcb

## KiCad design STM32 - BLDC Driver/STM32 - BLDC Driver.kicad_pcb (continued)

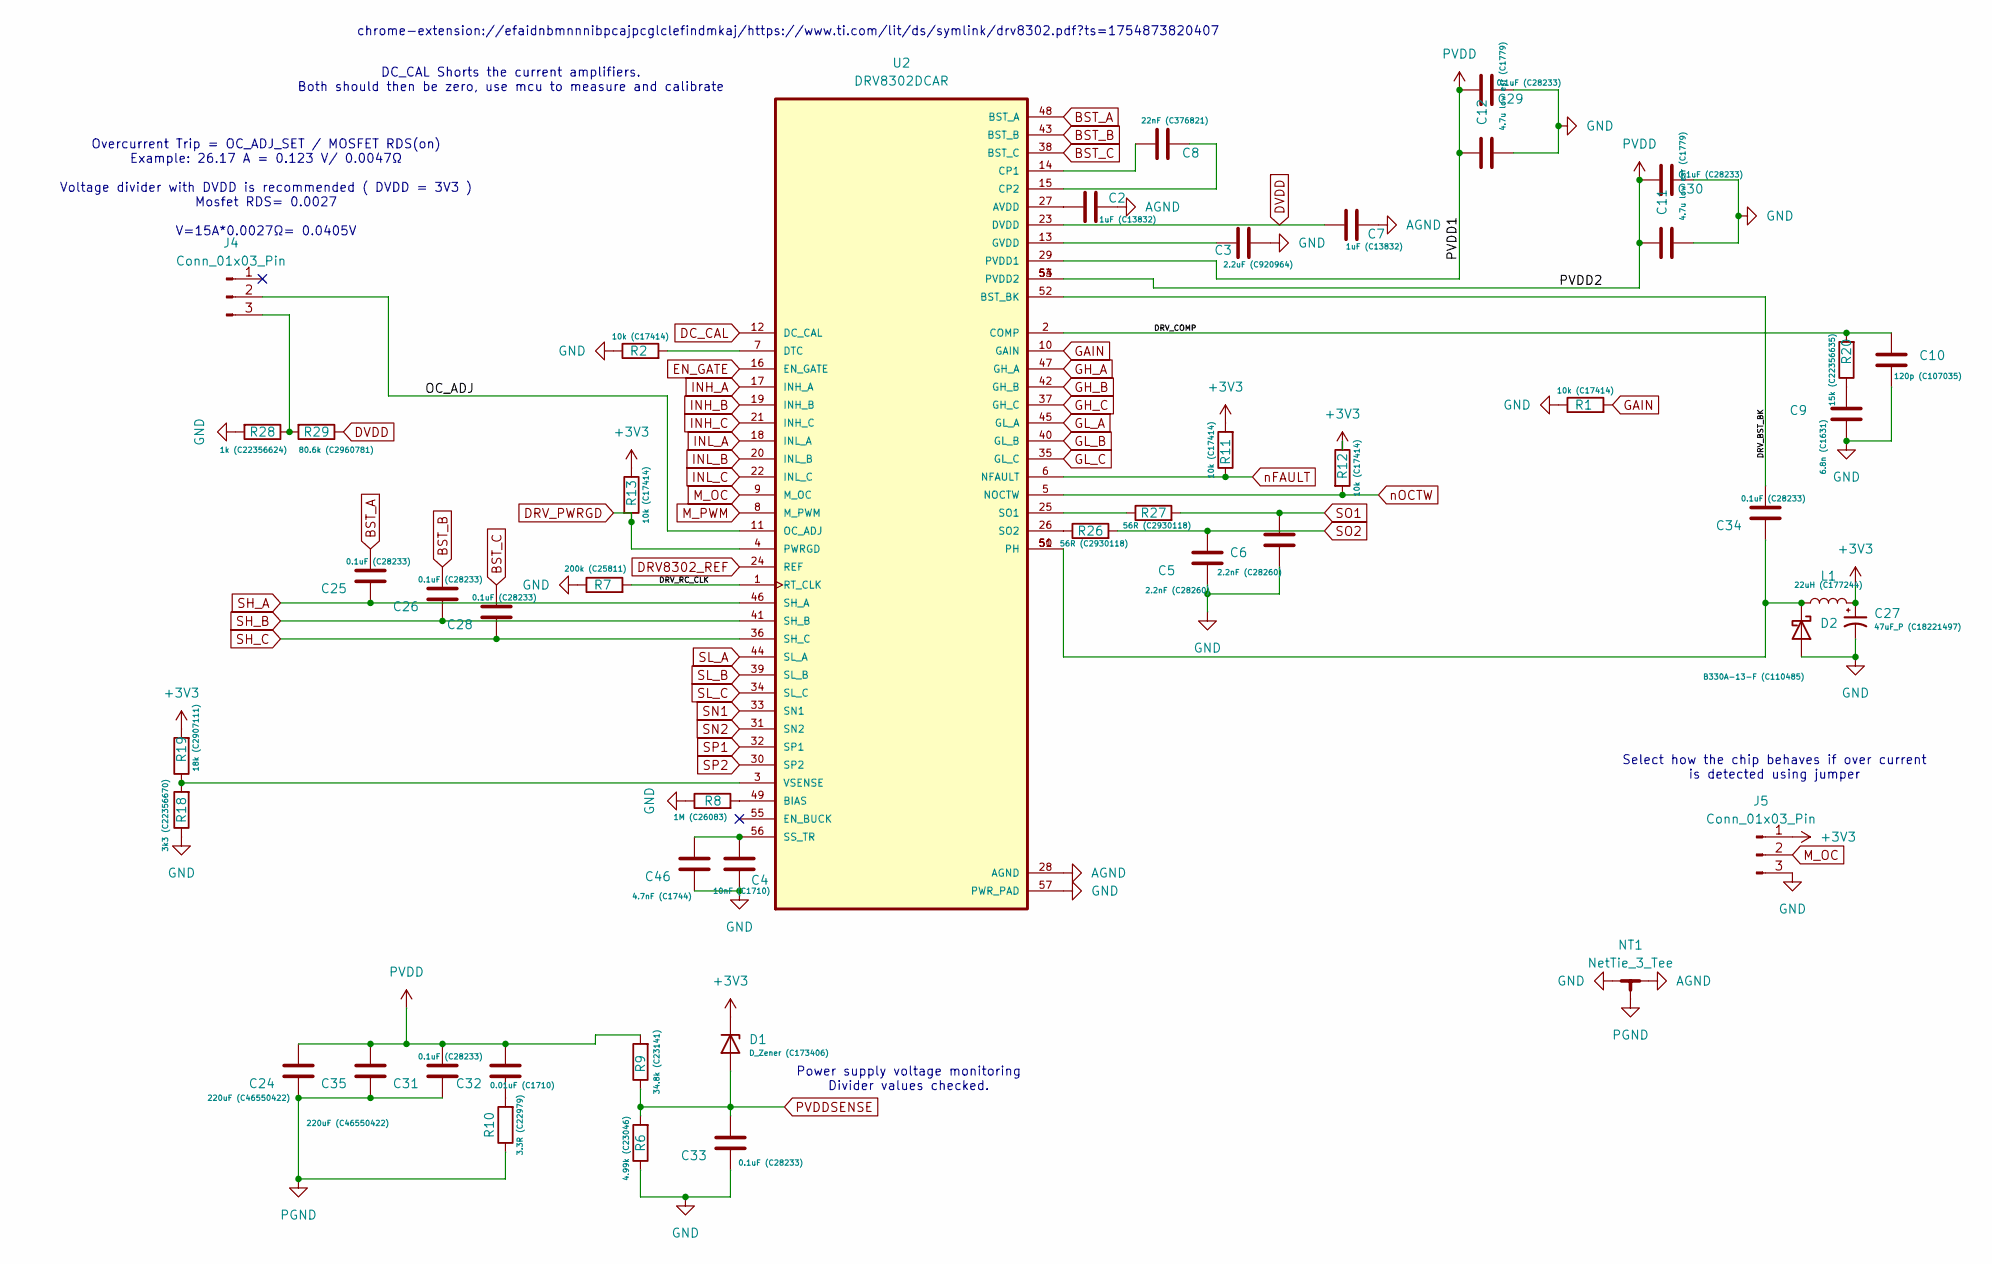
[picture p20: schematic DRV8302DCAR.kicad_sch]

Parts:
C2, C7: 1uF (C13832); C_1206_3216Metric_Pad1.33x1.80mm_HandSolder
C3: 2.2uF (C920964); C_1206_3216Metric_Pad1.33x1.80mm_HandSolder
C4: 10nF (C1710); C_0805_2012Metric_Pad1.18x1.45mm_HandSolder
C5, C6: 2.2nF (C28260); C_0805_2012Metric_Pad1.18x1.45mm_HandSolder
C8: 22nF (C376821); C_0603_1608Metric_Pad1.08x0.95mm_HandSolder
C9: 6.8n (C1631); C_0603_1608Metric_Pad1.08x0.95mm_HandSolder
C10: 120p (C107035); C_0603_1608Metric_Pad1.08x0.95mm_HandSolder
C11, C12: 4.7u low esr (C1779); C_0805_2012Metric_Pad1.18x1.45mm_HandSolder
C24, C35: 220uF (C46550422); C_Elec_10x10.2
C25, C26, C28, C29, C30, C31, C33, C34: 0.1uF (C28233); C_0805_2012Metric_Pad1.18x1.45mm_HandSolder
C27: 47uF_P (C18221497); CP_Elec_5x5.4
C32: 0.01uF (C1710); C_0805_2012Metric_Pad1.18x1.45mm_HandSolder
C46: 4.7nF (C1744); C_0805_2012Metric_Pad1.18x1.45mm_HandSolder
D1: D_Zener (C173406); D_SOD-123
D2: B330A-13-F (C110485); D_SMA-SMB_Universal_Handsoldering
J4, J5: Conn_01x03_Pin; PinHeader_1x03_P2.54mm_Vertical
L1: 22uH (C177244); L_Changjiang_FXL0630
NT1: NetTie_3_Tee; NetTie-3_SMD_Pad2.0mm
R1, R2, R11, R12, R13: 10k (C17414); R_0805_2012Metric_Pad1.20x1.40mm_HandSolder
R6: 4.99k (C23046); R_0603_1608Metric_Pad0.98x0.95mm_HandSolder
R7: 200k (C25811); R_0603_1608Metric_Pad0.98x0.95mm_HandSolder
R8: 1M (C26083); R_0402_1005Metric_Pad0.72x0.64mm_HandSolder
R9: 34.8k (C23141); R_0603_1608Metric_Pad0.98x0.95mm_HandSolder
R10: 3.3R (C22979); R_0603_1608Metric_Pad0.98x0.95mm_HandSolder
R18: 3k3 (C22356670); R_0603_1608Metric_Pad0.98x0.95mm_HandSolder
R19: 18k (C2907111); R_0603_1608Metric_Pad0.98x0.95mm_HandSolder
R20: 15k (C22356635); R_0603_1608Metric_Pad0.98x0.95mm_HandSolder
R26, R27: 56R (C2930118); R_0603_1608Metric_Pad0.98x0.95mm_HandSolder
R28: 1k (C22356624); R_0603_1608Metric_Pad0.98x0.95mm_HandSolder
R29: 80.6k (C2960781); R_0805_2012Metric_Pad1.20x1.40mm_HandSolder
U2: DRV8302DCAR; SOP50P810X120-57N

Connections:
+3V3: C27.1, D1.1 (K), J5.1, L1.2, R11.2, R12.1, R13.1, R19.2; also elsewhere on the board
/DRV8302DCAR/DRV_BST_BK: C34.2, U2.52 (BST_BK)
/DRV8302DCAR/DRV_COMP: C10.1, R20.2, U2.2 (COMP)
/DRV8302DCAR/DRV_RC_CLK: R7.2, U2.1 (RT_CLK)
/DRV8302DCAR/OC_ADJ: J4.2, U2.11 (OC_ADJ)
AGND: C2.1, C7.1, NT1.2, U2.28 (AGND)
BST_A: C25.2, U2.48 (BST_A)
BST_B: C26.2, U2.43 (BST_B)
BST_C: C28.2, U2.38 (BST_C)
DC_CAL: U2.12 (DC_CAL); also elsewhere on the board
DRV8302_REF: U2.24 (REF); also elsewhere on the board
DRV_PWRGD: R13.2, U2.4 (PWRGD)
DVDD: C7.2, R29.1, U2.23 (DVDD)
EN_GATE: U2.16 (EN_GATE); also elsewhere on the board
GAIN: R1.2, U2.10 (GAIN)
GH_A: U2.47 (GH_A); also elsewhere on the board
GH_B: U2.42 (GH_B); also elsewhere on the board
GH_C: U2.37 (GH_C); also elsewhere on the board
GL_A: U2.45 (GL_A); also elsewhere on the board
GL_B: U2.40 (GL_B); also elsewhere on the board
GL_C: U2.35 (GL_C); also elsewhere on the board
GND: C3.1, C4.1, C5.1, C6.1, C9.2, C10.2, C11.2, C12.2, C27.2, C29.1, C30.1, C33.1, C46.1, D2.2 (A), J5.3, NT1.1, R1.1, R2.1, R6.1, R7.1, R8.1, R18.1, R28.2, U2.57 (PWR_PAD); also elsewhere on the board
INH_A: U2.17 (INH_A); also elsewhere on the board
INH_B: U2.19 (INH_B); also elsewhere on the board
INH_C: U2.21 (INH_C); also elsewhere on the board
INL_A: U2.18 (INL_A); also elsewhere on the board
INL_B: U2.20 (INL_B); also elsewhere on the board
INL_C: U2.22 (INL_C); also elsewhere on the board
M_OC: J5.2, U2.9 (M_OC)
M_PWM: U2.8 (M_PWM); also elsewhere on the board
unnamed: C9.1, R20.1
unnamed: C32.1, R10.2
unnamed: C34.1, D2.1 (K), L1.1, U2.50 (PH), U2.51 (PH)
unnamed: J4.3, R28.1, R29.2
unnamed: C2.2, U2.27 (AVDD)
unnamed: R8.2, U2.49 (BIAS)
unnamed: C8.2, U2.14 (CP1)
unnamed: C8.1, U2.15 (CP2)
unnamed: R2.2, U2.7 (DTC)
unnamed: C3.2, U2.13 (GVDD)
unnamed: R27.1, U2.25 (SO1)
unnamed: R26.1, U2.26 (SO2)
unnamed: C4.2, C46.2, U2.56 (SS_TR)
unnamed: R18.2, R19.1, U2.3 (VSENSE)
PGND: C24.1, C31.1, C35.1, NT1.3, R10.1; also elsewhere on the board
PVDD: C11.1, C12.1, C24.2, C29.2, C30.2, C31.2, C32.2, C35.2, R9.2, U2.29 (PVDD1), U2.53 (PVDD2), U2.54 (PVDD2); also elsewhere on the board
PVDDSENSE: C33.2, D1.2 (A), R6.2, R9.1; also elsewhere on the board
SH_A: C25.1, U2.46 (SH_A); also elsewhere on the board
SH_B: C26.1, U2.41 (SH_B); also elsewhere on the board
SH_C: C28.1, U2.36 (SH_C); also elsewhere on the board
SL_A: U2.44 (SL_A); also elsewhere on the board
SL_B: U2.39 (SL_B); also elsewhere on the board
SL_C: U2.34 (SL_C); also elsewhere on the board
SN1: U2.33 (SN1); also elsewhere on the board
SN2: U2.31 (SN2); also elsewhere on the board
SO1: C6.2, R27.2
SO2: C5.2, R26.2
SP1: U2.32 (SP1); also elsewhere on the board
SP2: U2.30 (SP2); also elsewhere on the board
nFAULT: R11.1, U2.6 (NFAULT); also elsewhere on the board
nOCTW: R12.2, U2.5 (NOCTW); also elsewhere on the board

Notes on the sheet:
Power supply voltage monitoring Divider values checked.
DC_CAL Shorts the current amplifiers. Both should then be zero, use mcu to measure and calibrate
Select how the chip behaves if over current is detected using jumper
chrome-extension://efaidnbmnnnibpcajpcglclefindmkaj/https://www.ti.com/lit/ds/symlink/drv8302.pdf?ts=1754873820407
Overcurrent Trip = OC_ADJ_SET / MOSFET RDS(on) Example: 26.17 A = 0.123 V/ 0.0047Ω Voltage divider with DVDD is recommended ( DVDD = 3V3 ) Mosfet RDS= 0.0027 V=15A*0.0027Ω= 0.0405V

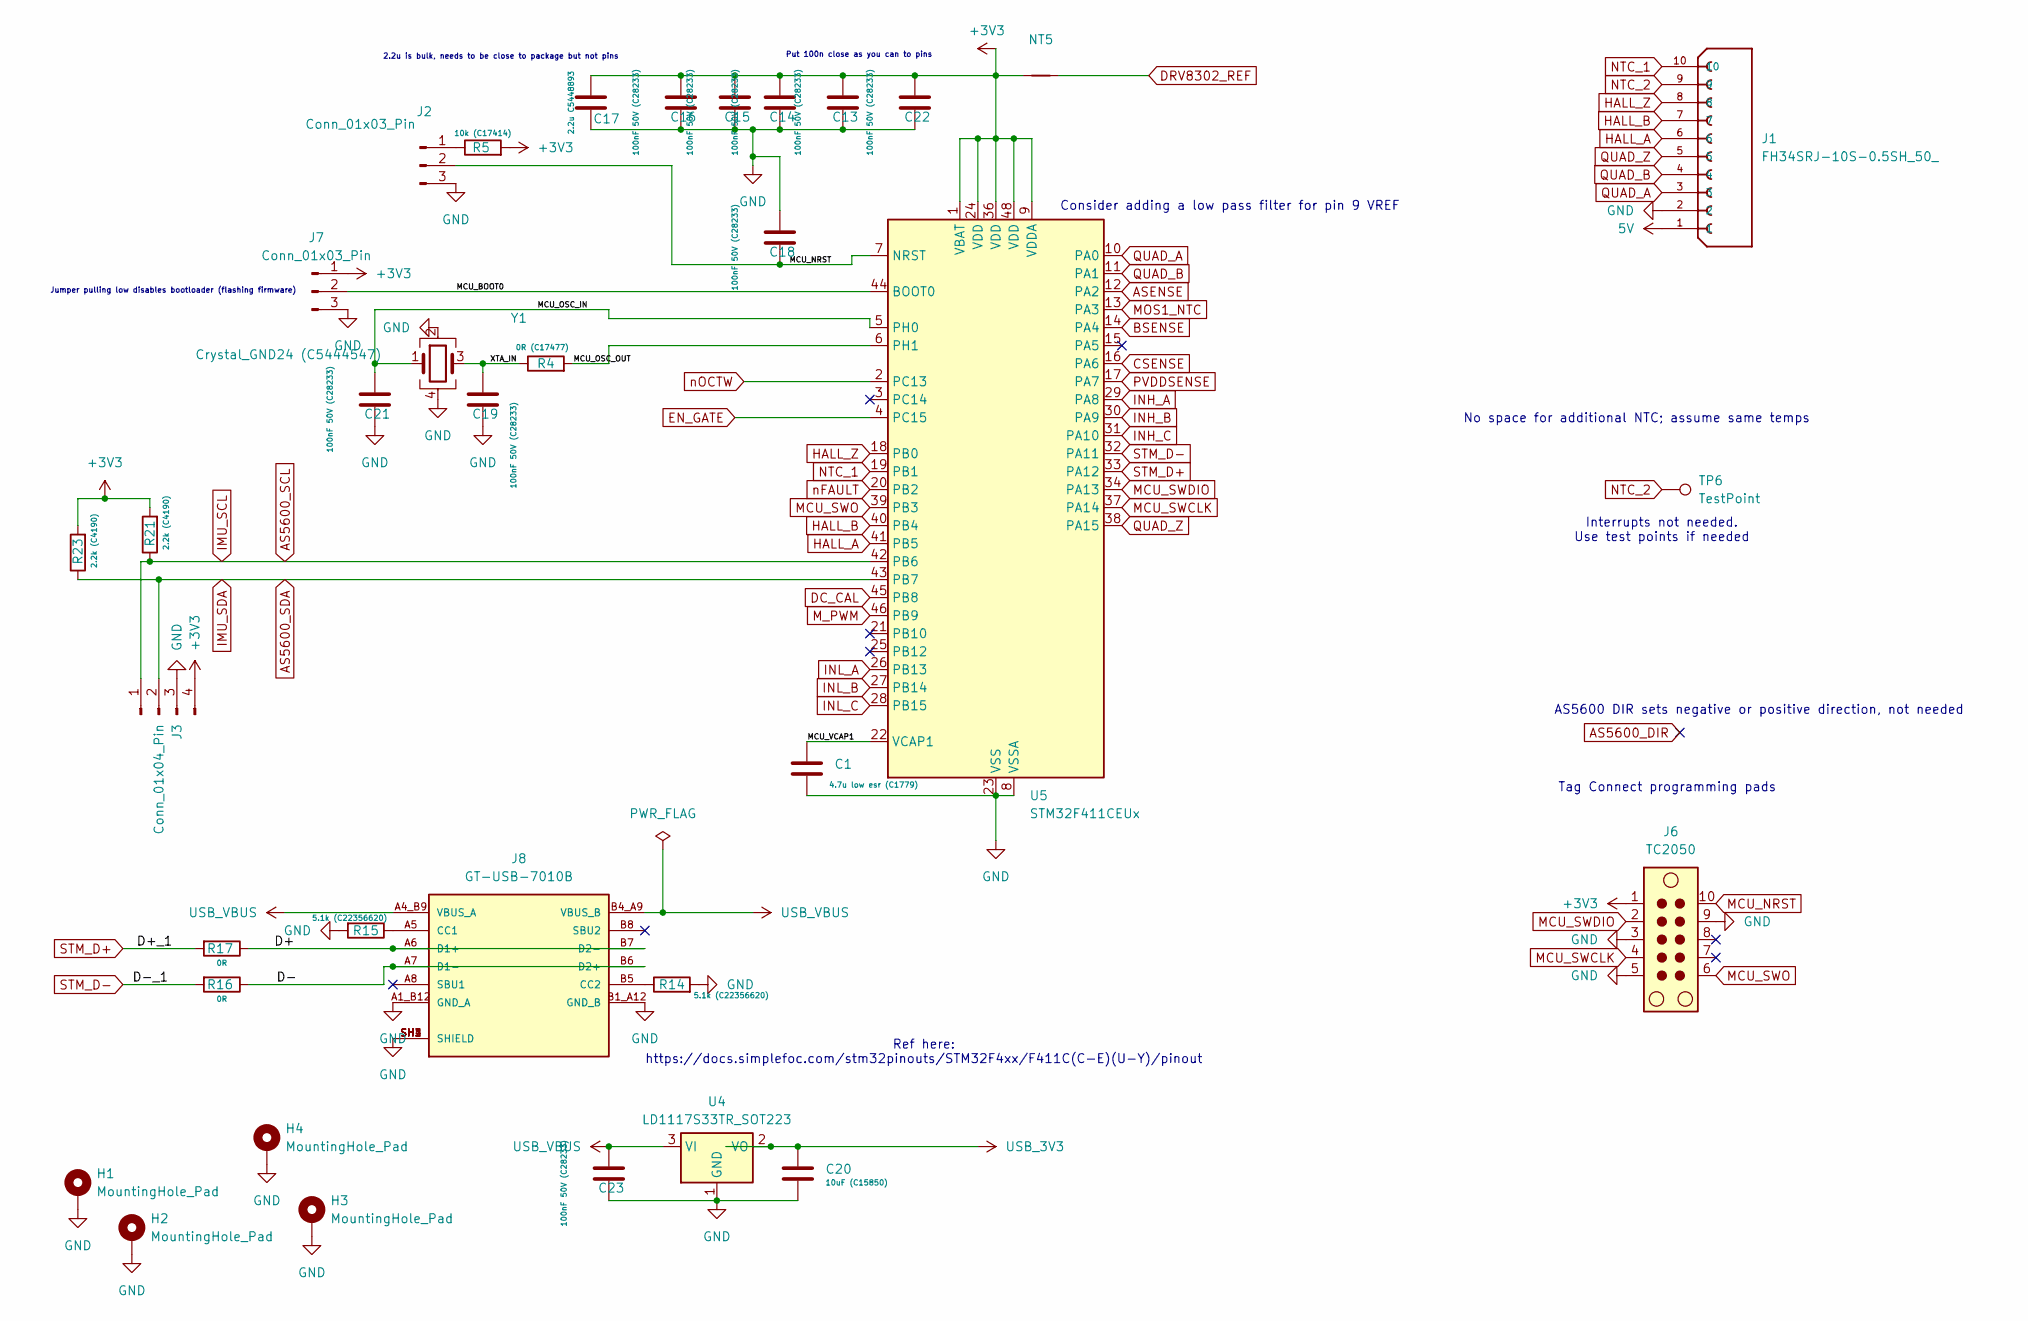
[picture p21: schematic STM32G.kicad_sch]

Parts:
C1: 4.7u low esr (C1779); C_0805_2012Metric_Pad1.18x1.45mm_HandSolder
C13, C14, C15, C16, C18, C19, C21, C22, C23: 100nF 50V (C28233); C_0805_2012Metric_Pad1.18x1.45mm_HandSolder
C17: 2.2u C5448893; C_0805_2012Metric_Pad1.18x1.45mm_HandSolder
C20: 10uF (C15850); C_0805_2012Metric_Pad1.18x1.45mm_HandSolder
H1, H2, H3, H4: MountingHole_Pad; MountingHole_3.2mm_M3_Pad_Via
J1: FH34SRJ-10S-0.5SH_50_; HRS_FH34SRJ-10S-0.5SH_50_; PARTREV Apr.1.2022
J2, J7: Conn_01x03_Pin; PinHeader_1x03_P2.54mm_Vertical
J3: Conn_01x04_Pin; PinHeader_1x04_P2.54mm_Vertical
J6: TC2050; Tag-Connect_TC2050-IDC-NL_2x05_P1.27mm_Vertical
J8: GT-USB-7010B; G-SWITCH_GT-USB-7010B; PARTREV A0
NT5: NetTie_2; NetTie-2_SMD_Pad0.5mm
R4: 0R (C17477); R_0805_2012Metric_Pad1.20x1.40mm_HandSolder
R5: 10k (C17414); R_0805_2012Metric_Pad1.20x1.40mm_HandSolder
R14, R15: 5.1k (C22356620); R_0603_1608Metric_Pad0.98x0.95mm_HandSolder
R16, R17: 0R; R_0603_1608Metric_Pad0.98x0.95mm_HandSolder
R21, R23: 2.2k (C4190); R_0603_1608Metric_Pad0.98x0.95mm_HandSolder
TP6: TestPoint; TestPoint_Pad_D4.0mm
U4: LD1117S33TR_SOT223; SOT-223-3_TabPin2
U5: STM32F411CEUx; QFN-48-1EP_7x7mm_P0.5mm_EP5.6x5.6mm
Y1: Crystal_GND24 (C5444547); Crystal_SMD_3225-4Pin_3.2x2.5mm_HandSoldering

Connections:
5V: J1.1; also elsewhere on the board
+3V3: C13.2, C14.2, C15.2, C16.2, C17.1, C22.2, J3.4, J6.1, J7.1, NT5.1, R5.2, R21.2, R23.2, U5.1 (VBAT), U5.9 (VDDA), U5.24 (VDD), U5.36 (VDD), U5.48 (VDD); also elsewhere on the board
/STM32G/D+: J8.A6 (D1+), J8.B7 (D2-), R17.1
/STM32G/D-: J8.A7 (D1-), J8.B6 (D2+), R16.1
/STM32G/MCU_BOOT0: J7.2, U5.44 (BOOT0)
/STM32G/MCU_OSC_IN: C21.2, U5.5 (PH0), Y1.1
/STM32G/MCU_OSC_OUT: R4.2, U5.6 (PH1)
/STM32G/MCU_VCAP1: C1.1, U5.22 (VCAP1)
/STM32G/XTA_IN: C19.2, R4.1, Y1.3
AS5600_SCL: J3.1, R21.1, U5.42 (PB6)
AS5600_SDA: J3.2, R23.1, U5.43 (PB7)
ASENSE: U5.12 (PA2); also elsewhere on the board
BSENSE: U5.14 (PA4); also elsewhere on the board
CSENSE: U5.16 (PA6); also elsewhere on the board
DC_CAL: U5.45 (PB8); also elsewhere on the board
DRV8302_REF: NT5.2; also elsewhere on the board
EN_GATE: U5.4 (PC15); also elsewhere on the board
GND: C1.2, C13.1, C14.1, C15.1, C16.1, C17.2, C18.2, C19.1, C20.2, C21.1, C22.1, C23.1, H1.1, H2.1, H3.1, H4.1, J1.2, J2.3, J3.3, J6.3, J6.5, J6.9, J7.3, J8.A1_B12 (GND_A), J8.B1_A12 (GND_B), J8.SH1 (SHIELD), J8.SH2 (SHIELD), J8.SH3 (SHIELD), J8.SH4 (SHIELD), R14.2, R15.2, U4.1 (GND), U5.8 (VSSA), U5.23 (VSS), U5.35 (VSS), U5.47 (VSS), U5.49 (VSS), Y1.2, Y1.4; also elsewhere on the board
HALL_A: J1.6, U5.41 (PB5)
HALL_B: J1.7, U5.40 (PB4)
HALL_Z: J1.8, U5.18 (PB0)
INH_A: U5.29 (PA8); also elsewhere on the board
INH_B: U5.30 (PA9); also elsewhere on the board
INH_C: U5.31 (PA10); also elsewhere on the board
INL_A: U5.26 (PB13); also elsewhere on the board
INL_B: U5.27 (PB14); also elsewhere on the board
INL_C: U5.28 (PB15); also elsewhere on the board
MCU_NRST: C18.1, J2.2, J6.10, U5.7 (NRST)
MCU_SWCLK: J6.4, U5.37 (PA14)
MCU_SWDIO: J6.2, U5.34 (PA13)
MCU_SWO: J6.6, U5.39 (PB3)
MOS1_NTC: U5.13 (PA3); also elsewhere on the board
M_PWM: U5.46 (PB9); also elsewhere on the board
NTC_1: J1.10, U5.19 (PB1)
NTC_2: J1.9, TP6.1
unnamed: J2.1, R5.1
unnamed: J8.A5 (CC1), R15.1
unnamed: J8.B5 (CC2), R14.1
PVDDSENSE: U5.17 (PA7); also elsewhere on the board
QUAD_A: J1.3, U5.10 (PA0)
QUAD_B: J1.4, U5.11 (PA1)
QUAD_Z: J1.5, U5.38 (PA15)
STM_D+: R17.2, U5.33 (PA12)
STM_D-: R16.2, U5.32 (PA11)
USB_3V3: C20.1, U4.2 (VO); also elsewhere on the board
USB_VBUS: C23.2, J8.A4_B9 (VBUS_A), J8.B4_A9 (VBUS_B), U4.3 (VI)
nFAULT: U5.20 (PB2); also elsewhere on the board
nOCTW: U5.2 (PC13); also elsewhere on the board

Notes on the sheet:
Jumper pulling low disables bootloader (flashing firmware)
Consider adding a low pass filter for pin 9 VREF
Interrupts not needed. Use test points if needed
Ref here: https://docs.simplefoc.com/stm32pinouts/STM32F4xx/F411C(C-E)(U-Y)/pinout
2.2u is bulk, needs to be close to package but not pins
AS5600 DIR sets negative or positive direction, not needed
No space for additional NTC; assume same temps
Put 100n close as you can to pins
Tag Connect programming pads

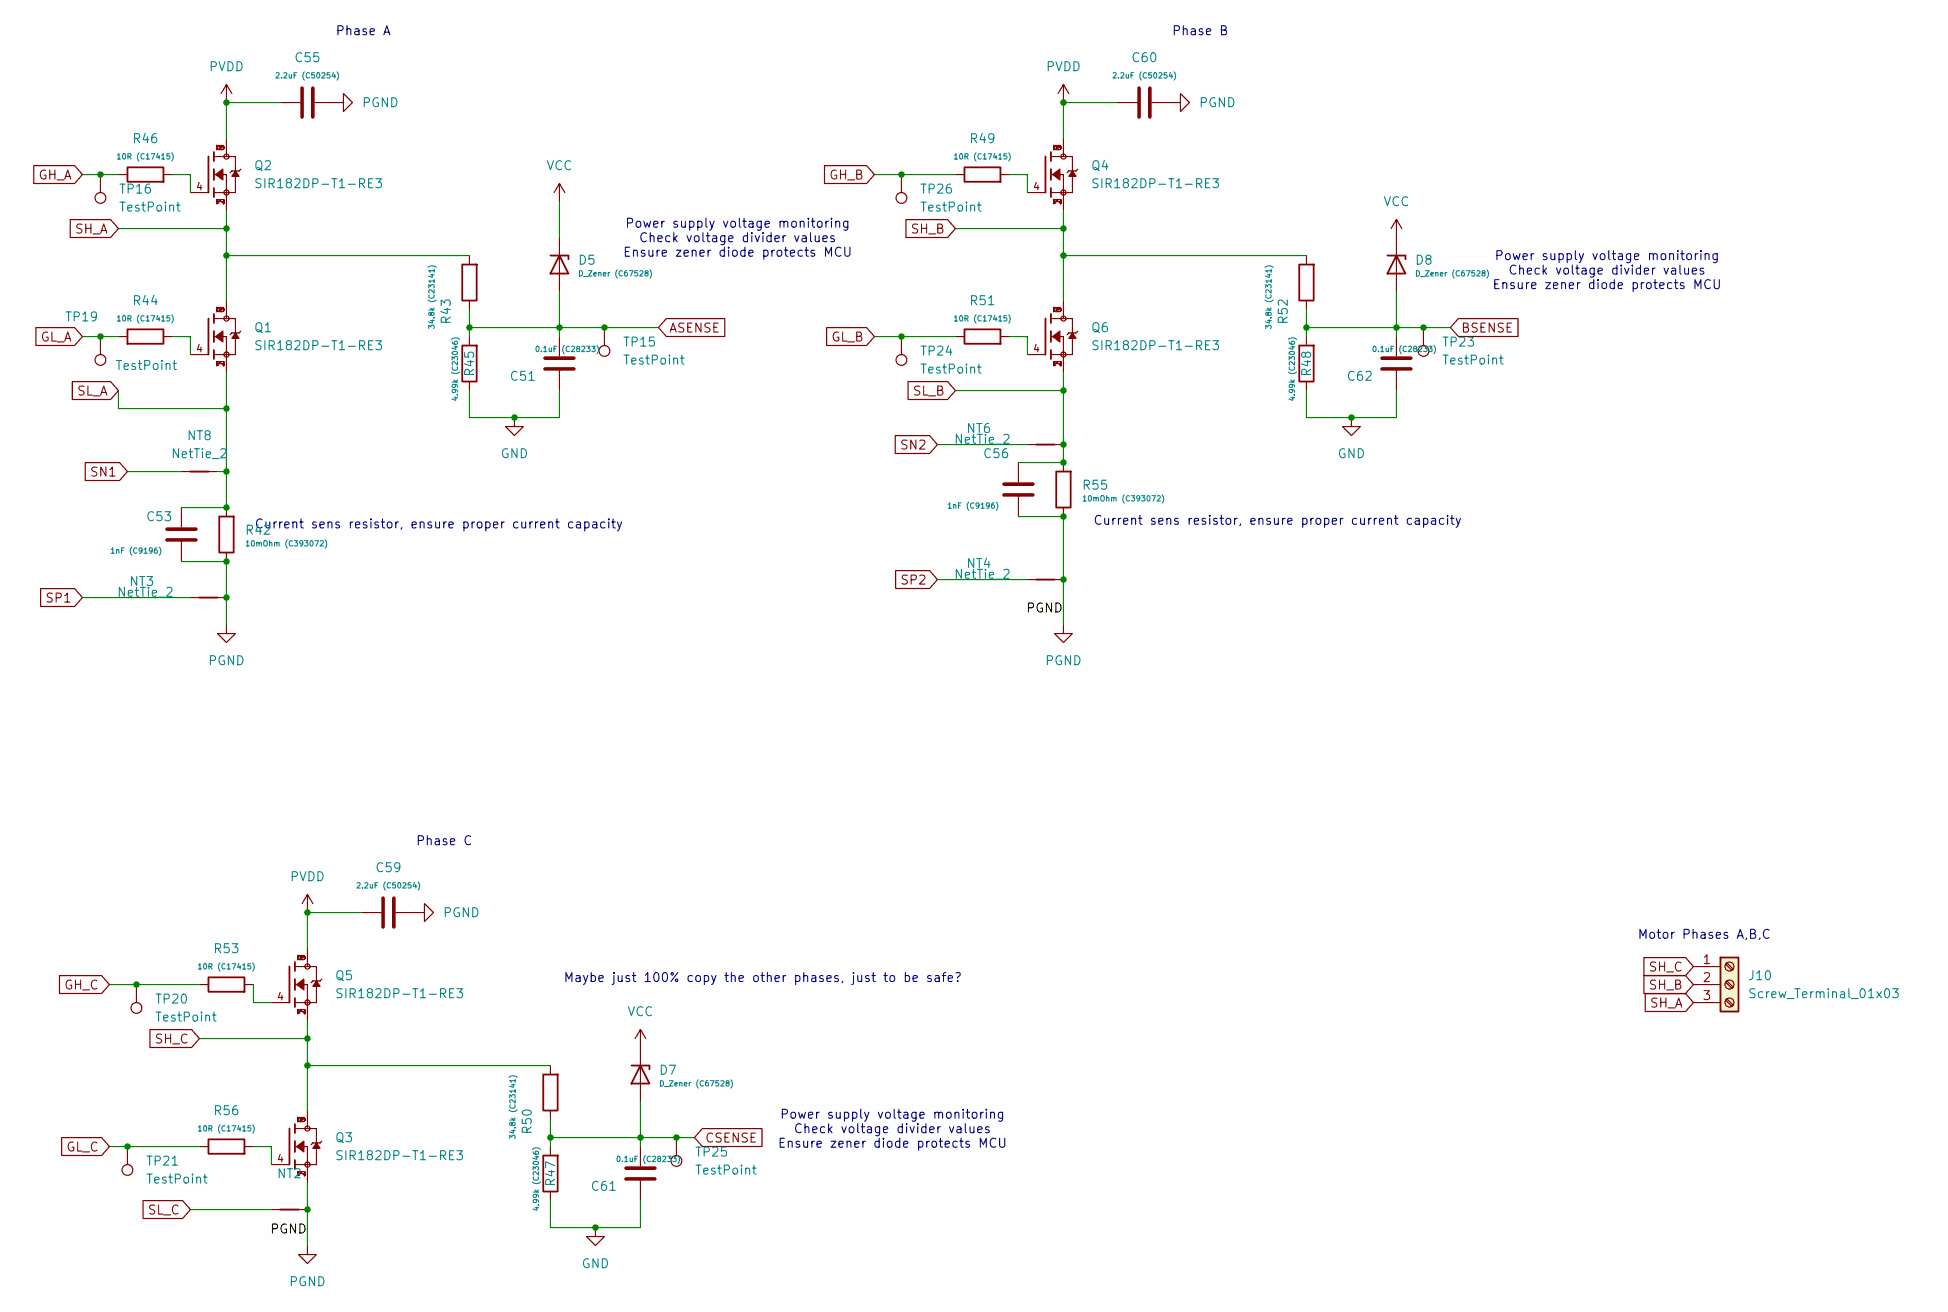
[picture p22: schematic BLDC MOSFETS.kicad_sch]

Parts:
C51, C61, C62: 0.1uF (C28233); C_0805_2012Metric_Pad1.18x1.45mm_HandSolder
C53: 1nF (C9196); C_1206_3216Metric
C55, C59, C60: 2.2uF (C50254); C_1206_3216Metric_Pad1.33x1.80mm_HandSolder
C56: 1nF (C9196); C_1206_3216Metric_Pad1.33x1.80mm_HandSolder
D5, D7, D8: D_Zener (C67528); D_SOD-323
J10: Screw_Terminal_01x03; TerminalBlock_bornier-3_P5.08mm
NT2, NT3, NT4, NT6, NT8: NetTie_2; NetTie-2_SMD_Pad0.5mm
Q1, Q2, Q3, Q4, Q5, Q6: SIR182DP-T1-RE3; TRANS_SIR182DP-T1-RE3; PARTREV B
R42, R55: 10mOhm (C393072); R_2512_6332Metric_Pad1.40x3.35mm_HandSolder
R43, R50, R52: 34.8k (C23141); R_0603_1608Metric_Pad0.98x0.95mm_HandSolder
R44, R46, R49, R51, R53, R56: 10R (C17415); R_0805_2012Metric_Pad1.20x1.40mm_HandSolder
R45, R47, R48: 4.99k (C23046); R_0603_1608Metric_Pad0.98x0.95mm_HandSolder
TP15, TP16, TP19, TP20, TP21, TP23, TP24, TP25, TP26: TestPoint; TestPoint_Pad_D3.0mm

Connections:
+3V3: D5.1 (K), D7.1 (K), D8.1 (K); also elsewhere on the board
ASENSE: C51.2, D5.2 (A), R43.1, R45.2, TP15.1; also elsewhere on the board
BSENSE: C62.2, D8.2 (A), R48.2, R52.1, TP23.1; also elsewhere on the board
CSENSE: C61.2, D7.2 (A), R47.2, R50.1, TP25.1; also elsewhere on the board
GH_A: R46.1, TP16.1; also elsewhere on the board
GH_B: R49.1, TP26.1; also elsewhere on the board
GH_C: R53.1, TP20.1; also elsewhere on the board
GL_A: R44.2, TP19.1; also elsewhere on the board
GL_B: R51.1, TP24.1; also elsewhere on the board
GL_C: R56.1, TP21.1; also elsewhere on the board
GND: C51.1, C61.1, C62.1, R45.1, R47.1, R48.1; also elsewhere on the board
unnamed: Q1.4, R44.1
unnamed: Q2.4, R46.2
unnamed: Q3.4, R56.2
unnamed: Q4.4, R49.2
unnamed: Q5.4, R53.2
unnamed: Q6.4, R51.2
PGND: C53.1, C55.2, C56.1, C59.2, C60.2, NT2.1, NT3.2, NT4.2, Q3.1, Q3.2, Q3.3, R42.1, R55.1; also elsewhere on the board
PVDD: C55.1, C59.1, C60.1, Q2.5, Q2.6, Q2.7, Q2.8, Q2.9, Q4.5, Q4.6, Q4.7, Q4.8, Q4.9, Q5.5, Q5.6, Q5.7, Q5.8, Q5.9; also elsewhere on the board
SH_A: J10.3, Q1.5, Q1.6, Q1.7, Q1.8, Q1.9, Q2.1, Q2.2, Q2.3, R43.2; also elsewhere on the board
SH_B: J10.2, Q4.1, Q4.2, Q4.3, Q6.5, Q6.6, Q6.7, Q6.8, Q6.9, R52.2; also elsewhere on the board
SH_C: J10.1, Q3.5, Q3.6, Q3.7, Q3.8, Q3.9, Q5.1, Q5.2, Q5.3, R50.2; also elsewhere on the board
SL_A: C53.2, NT8.2, Q1.1, Q1.2, Q1.3, R42.2; also elsewhere on the board
SL_B: C56.2, NT6.2, Q6.1, Q6.2, Q6.3, R55.2; also elsewhere on the board
SL_C: NT2.2; also elsewhere on the board
SN1: NT8.1; also elsewhere on the board
SN2: NT6.1; also elsewhere on the board
SP1: NT3.1; also elsewhere on the board
SP2: NT4.1; also elsewhere on the board

Notes on the sheet:
Power supply voltage monitoring Check voltage divider values Ensure zener diode protects MCU
Phase C
Current sens resistor, ensure proper current capacity
Motor Phases A,B,C
Phase B
Phase A
Maybe just 100% copy the other phases, just to be safe?

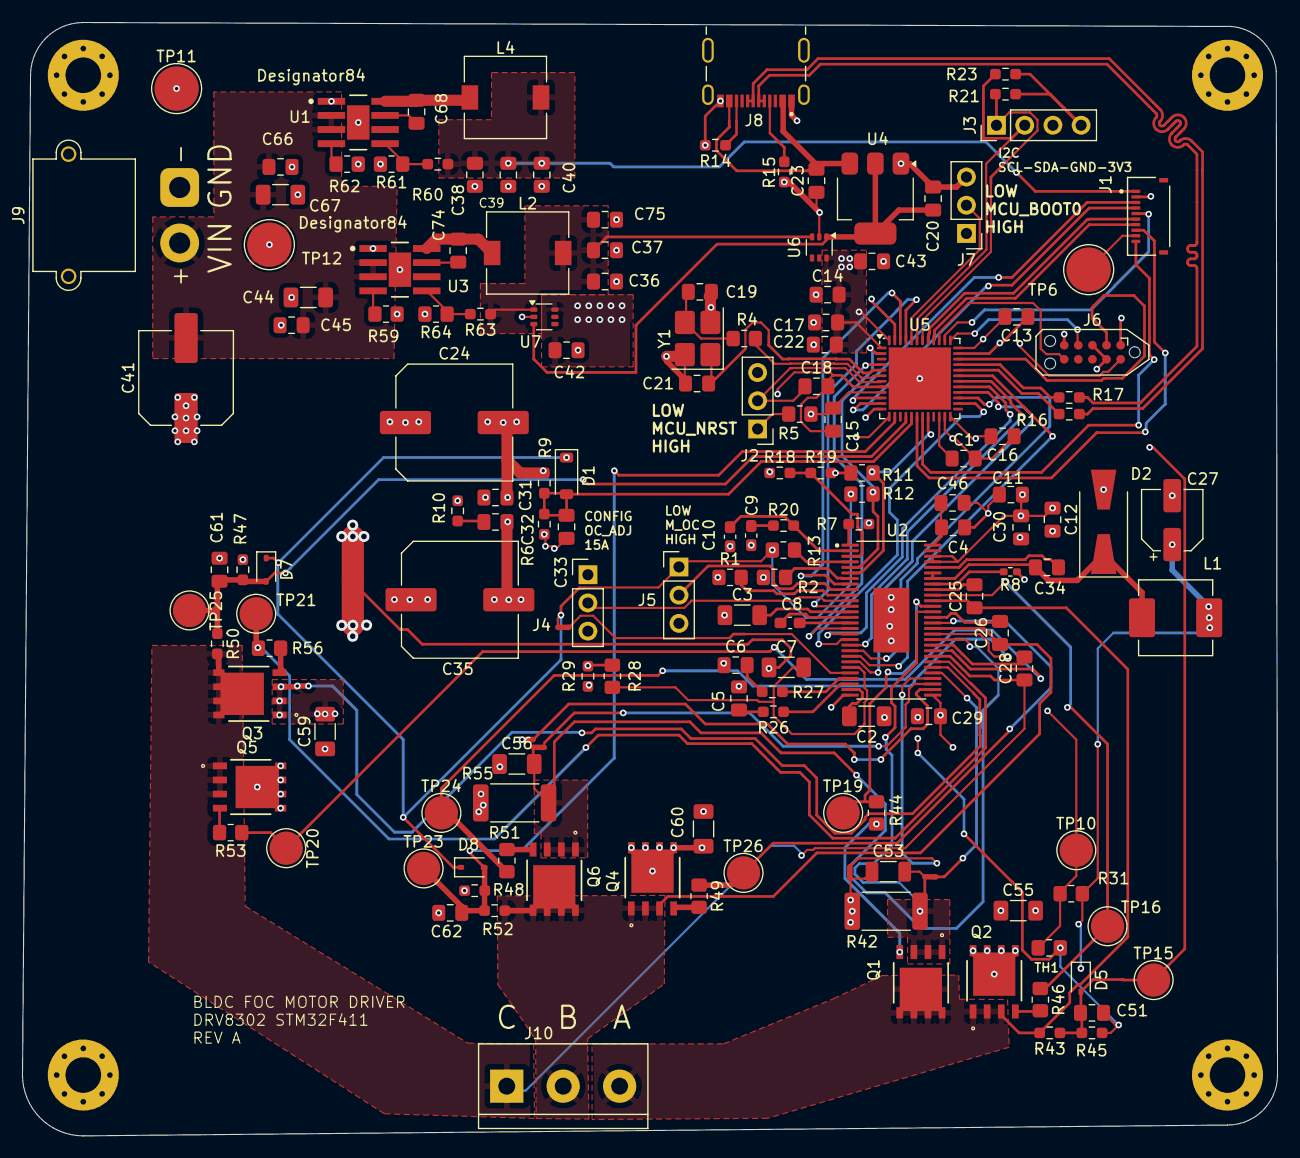
[picture p23: board STM32 - BLDC Driver.kicad_pcb from above]

Board: 4 copper layers, 113.0 x 100.2 mm, 162 parts (0 on the bottom side), 109 nets.
