FredrikLLarsen/STM32F411_DRV8302_FOC_PCBA/(commit log)

2025-08-23 Initial upload
    [BLDC MOSFETS.kicad_sch, DRV8302DCAR.kicad_sch, STM32 - BLDC Driver.kicad_pcb, STM32 - BLDC Driver.kicad_sch, STM32G.kicad_sch, Sensors.kicad_sch, untitled.kicad_sch]
2025-08-24 Started assigning footprints
    [STM32 - BLDC Driver.kicad_pcb, Sensors.kicad_sch, untitled.kicad_sch]
2026-10-09 As manufactured.
    [.step, AS5047P Encoder.kicad_pcb, AS5047P Encoder.kicad_sch, BLDC MOSFETS.kicad_sch, DRV8302DCAR.kicad_sch, FL50-15 Adapter.kicad_pcb, FL50-15 Adapter.kicad_sch, HOMEBREW_V3__bom.csv]
