FredrikLLarsen/STM32F411_DRV8302_FOC_PCBA/(notices)

Notices in the files:
Programming/Core/Inc/main.h:
Copyright (c) 2025 STMicroelectronics.
All rights reserved.
This software is licensed under terms that can be found in the LICENSE file
